skrishnachaitanya09/I-4.0-learning-Laboratory-/Documents/Presentation1.pdf

# Integration of Different Communication Protocols in Industry 4.0 Learning Laboratory

Srivamsi Malladi
Sri Girish Tangirala
Chaitanya Sankaramanchi

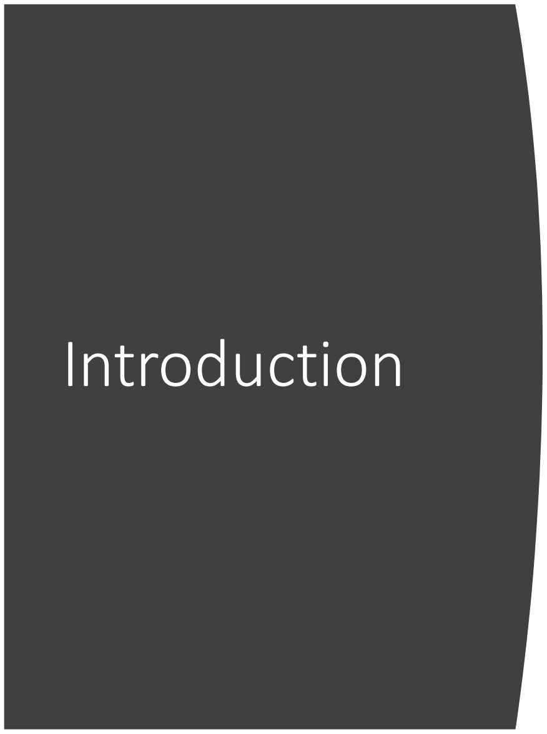
[picture p69: figure]
Introduction

With the increase in the usage of modular components and improvement of intelligence of the devices, the decentralization of the different nodes in a production plant is made possible.

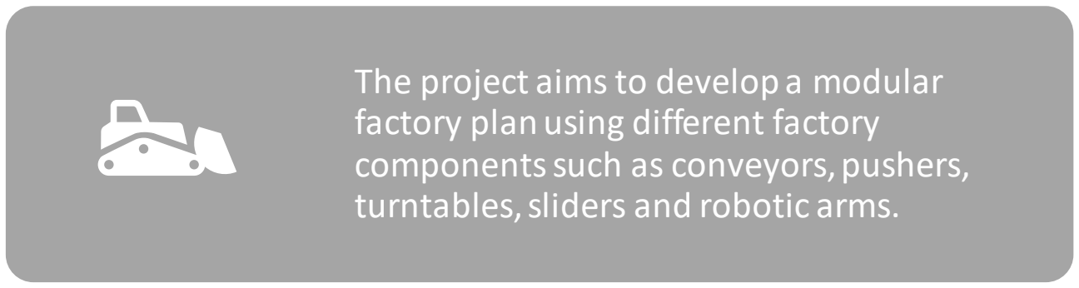
[picture p70: figure]
The project aims to develop a modular factory plan using different factory components such as conveyors, pushers, turntables, sliders and robotic arms.

The project also aims at embedding different communication protocols between the individual nodes in the production plant.

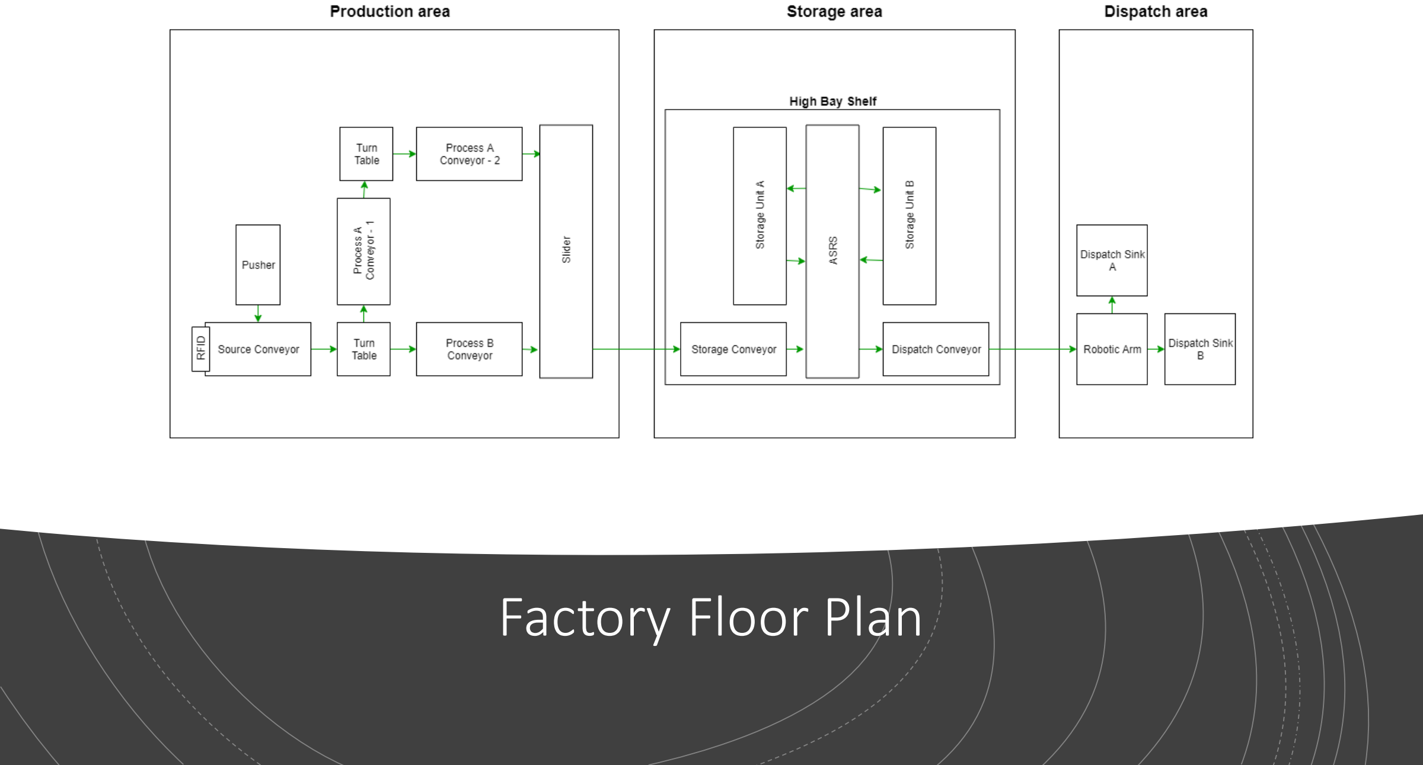
[picture p71: figure]
Factory Floor Plan

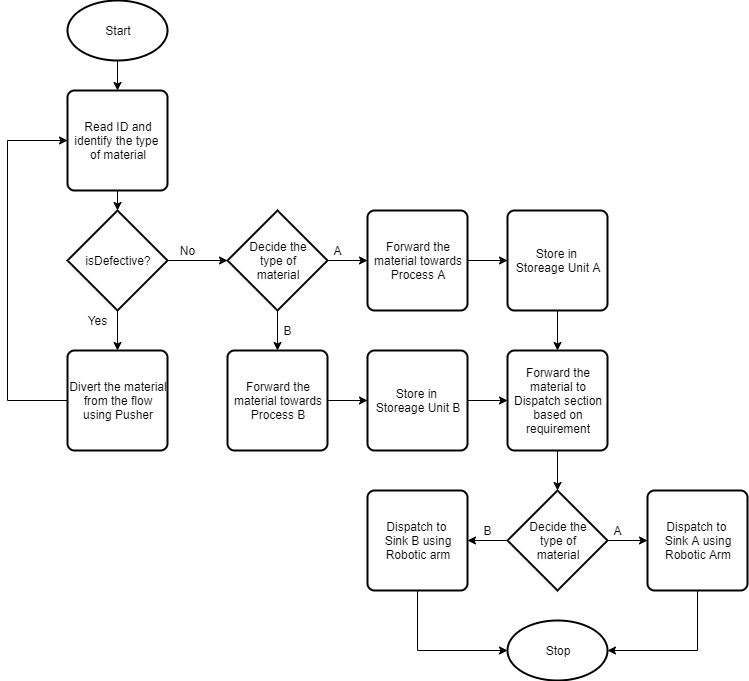
[picture p72: figure]

# Process Flowchart

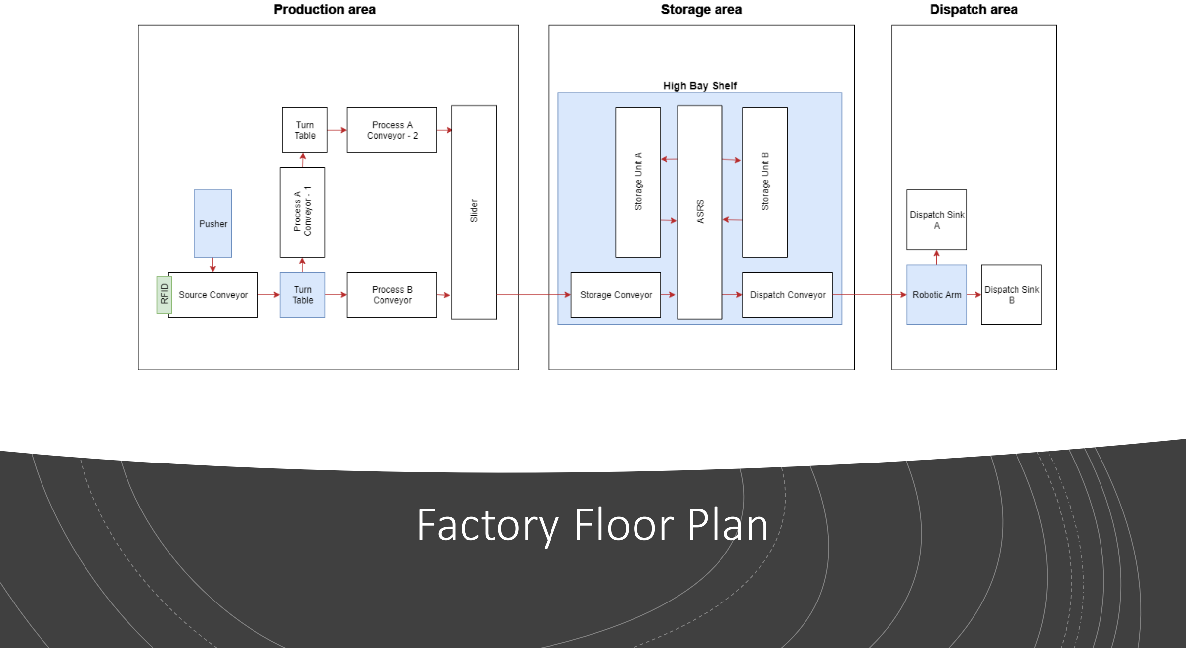
[picture p73: figure]
Factory Floor Plan

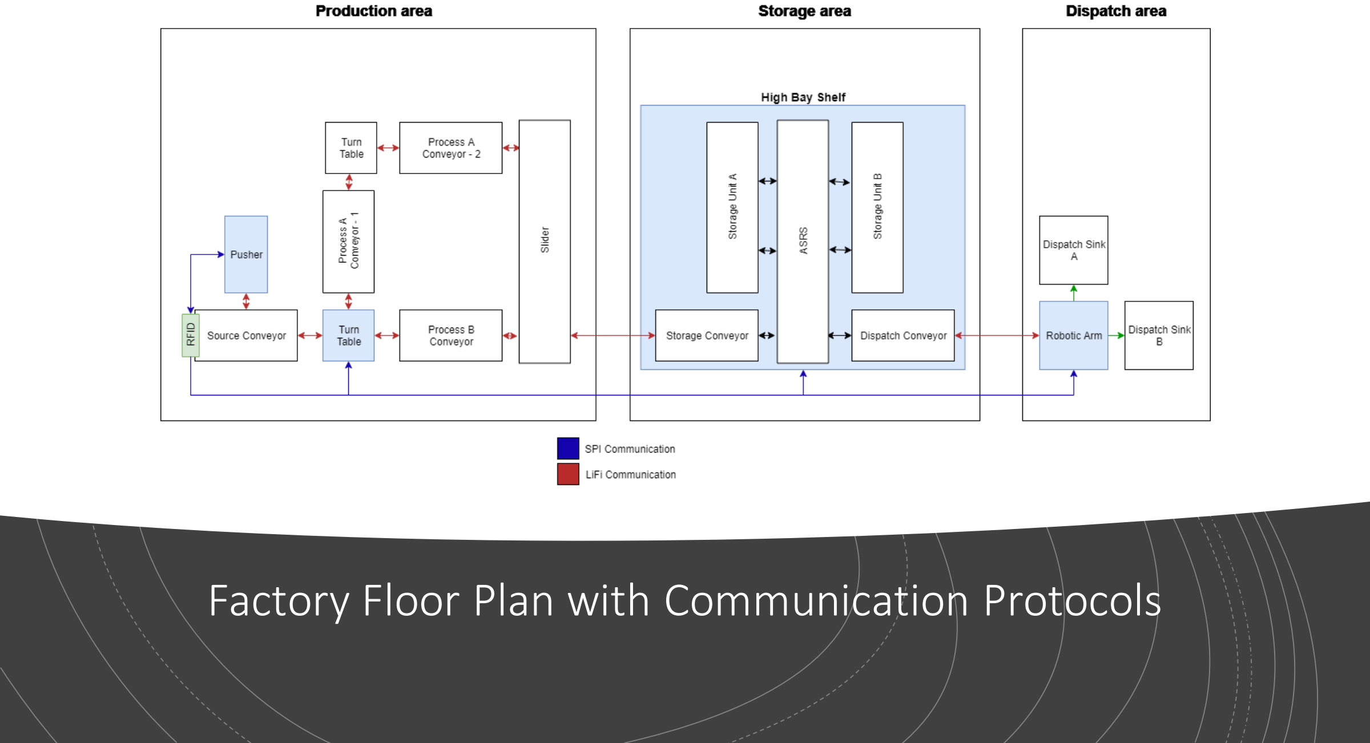
[picture p74: figure]

# Factory Floor Plan with Communication Protocols

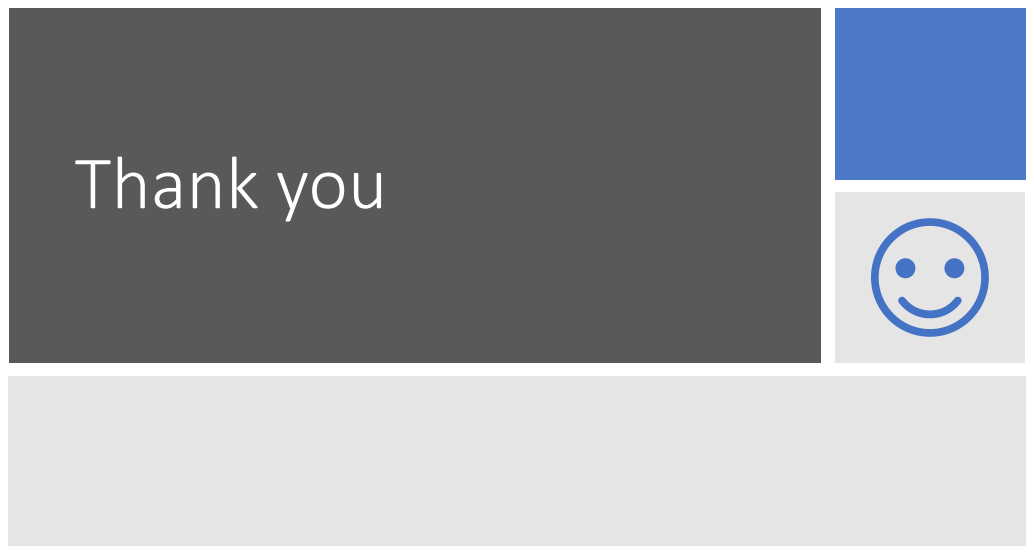
[picture p75: page 7]
Thank you
