skrishnachaitanya09/I-4.0-learning-Laboratory-/Circuit Schematics & Gerber Files/Fritzing/UARt_bb.png

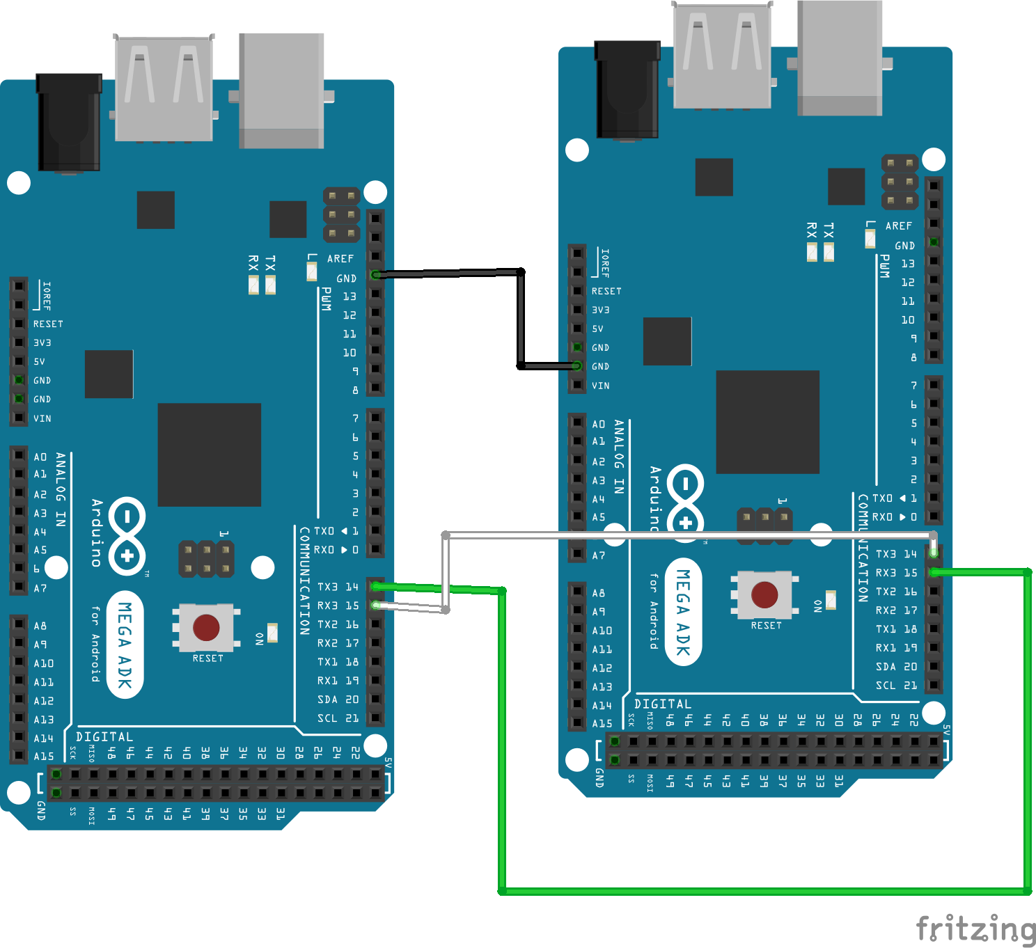
Circuit Schematics & Gerber Files/Fritzing/UARt_bb.png
