skrishnachaitanya09/I-4.0-learning-Laboratory-/Circuit Schematics & Gerber Files/highbay shelf1111/hbs_pcb/hbs_pcb.pdf

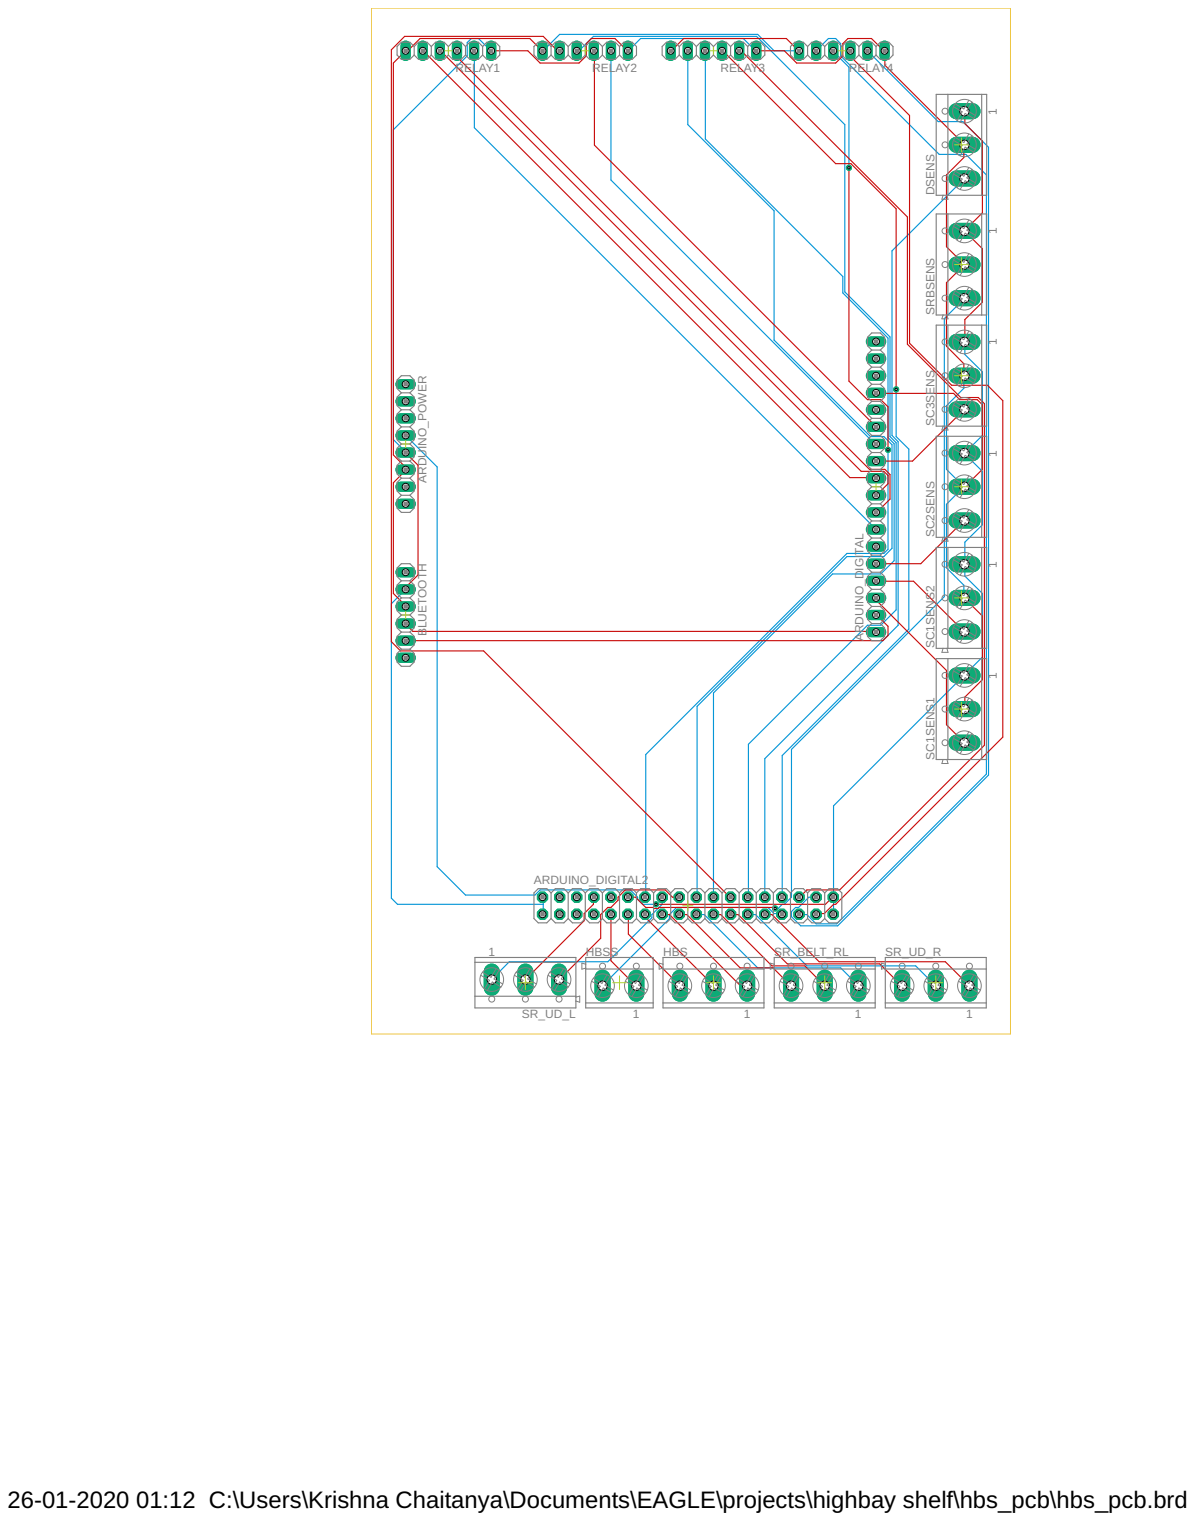
[picture p89: page 1]

26-01-2020 01:12 C:\Users\Krishna Chaitanya\Documents\EAGLE\projects\highbay shelf\hbs_pcb\hbs_pcb.brd
