skrishnachaitanya09/I-4.0-learning-Laboratory-/Circuit Schematics & Gerber Files/highbay shelf1111/hbs_pcb/hbs_pcb_sch.pdf

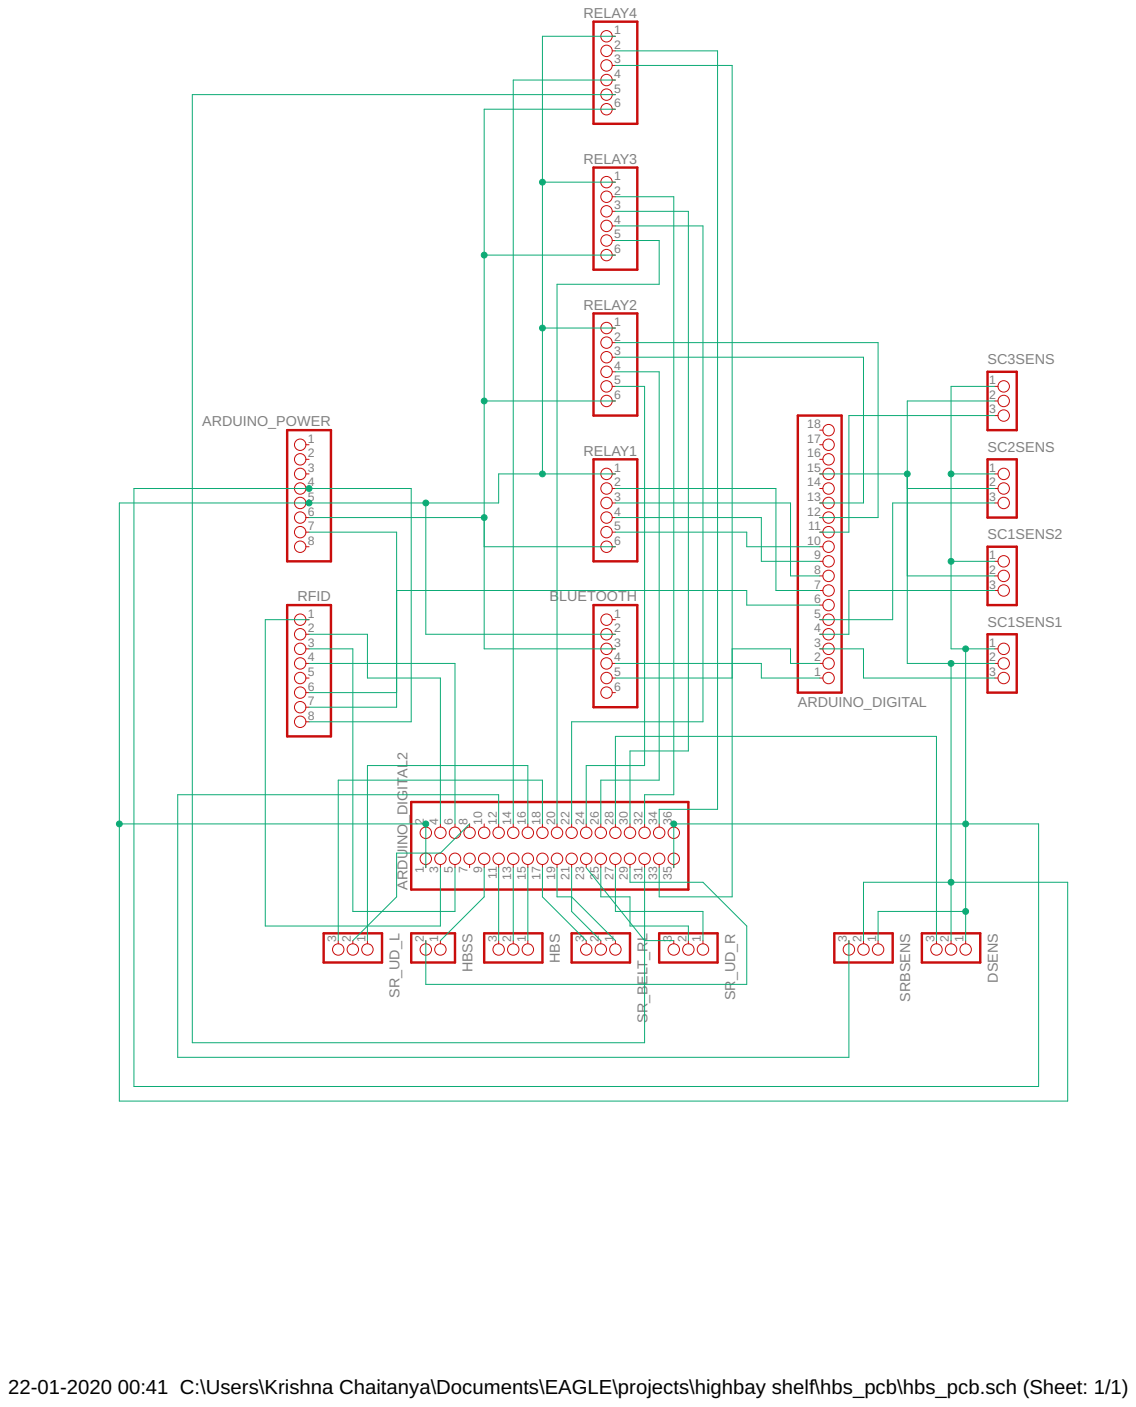
[picture p90: page 1]

22-01-2020 00:41 C:\Users\Krishna Chaitanya\Documents\EAGLE\projects\highbay shelf\hbs_pcb\hbs_pcb.sch (Sheet: 1/1)
