skrishnachaitanya09/I-4.0-learning-Laboratory-/(list of files, drawings)

Other design files:
Circuit Schematics & Gerber Files/Fritzing/bluetooth.fzz
Circuit Schematics & Gerber Files/Fritzing/ir.fzz
Circuit Schematics & Gerber Files/Fritzing/lifi.fzz
Circuit Schematics & Gerber Files/Fritzing/nrf.fzz
Circuit Schematics & Gerber Files/Fritzing/parts/user/relay.fzz
Circuit Schematics & Gerber Files/Fritzing/rfid.fzz
Circuit Schematics & Gerber Files/Fritzing/UARt.fzz
Circuit Schematics & Gerber Files/Fritzing/Untitled Sketch 2.fzz
