skrishnachaitanya09/I-4.0-learning-Laboratory-/Circuit Schematics & Gerber Files/shiield/final_shield/1.brd

## EAGLE design Circuit Schematics & Gerber Files/shiield/final_shield/1.brd (2020-11-26)

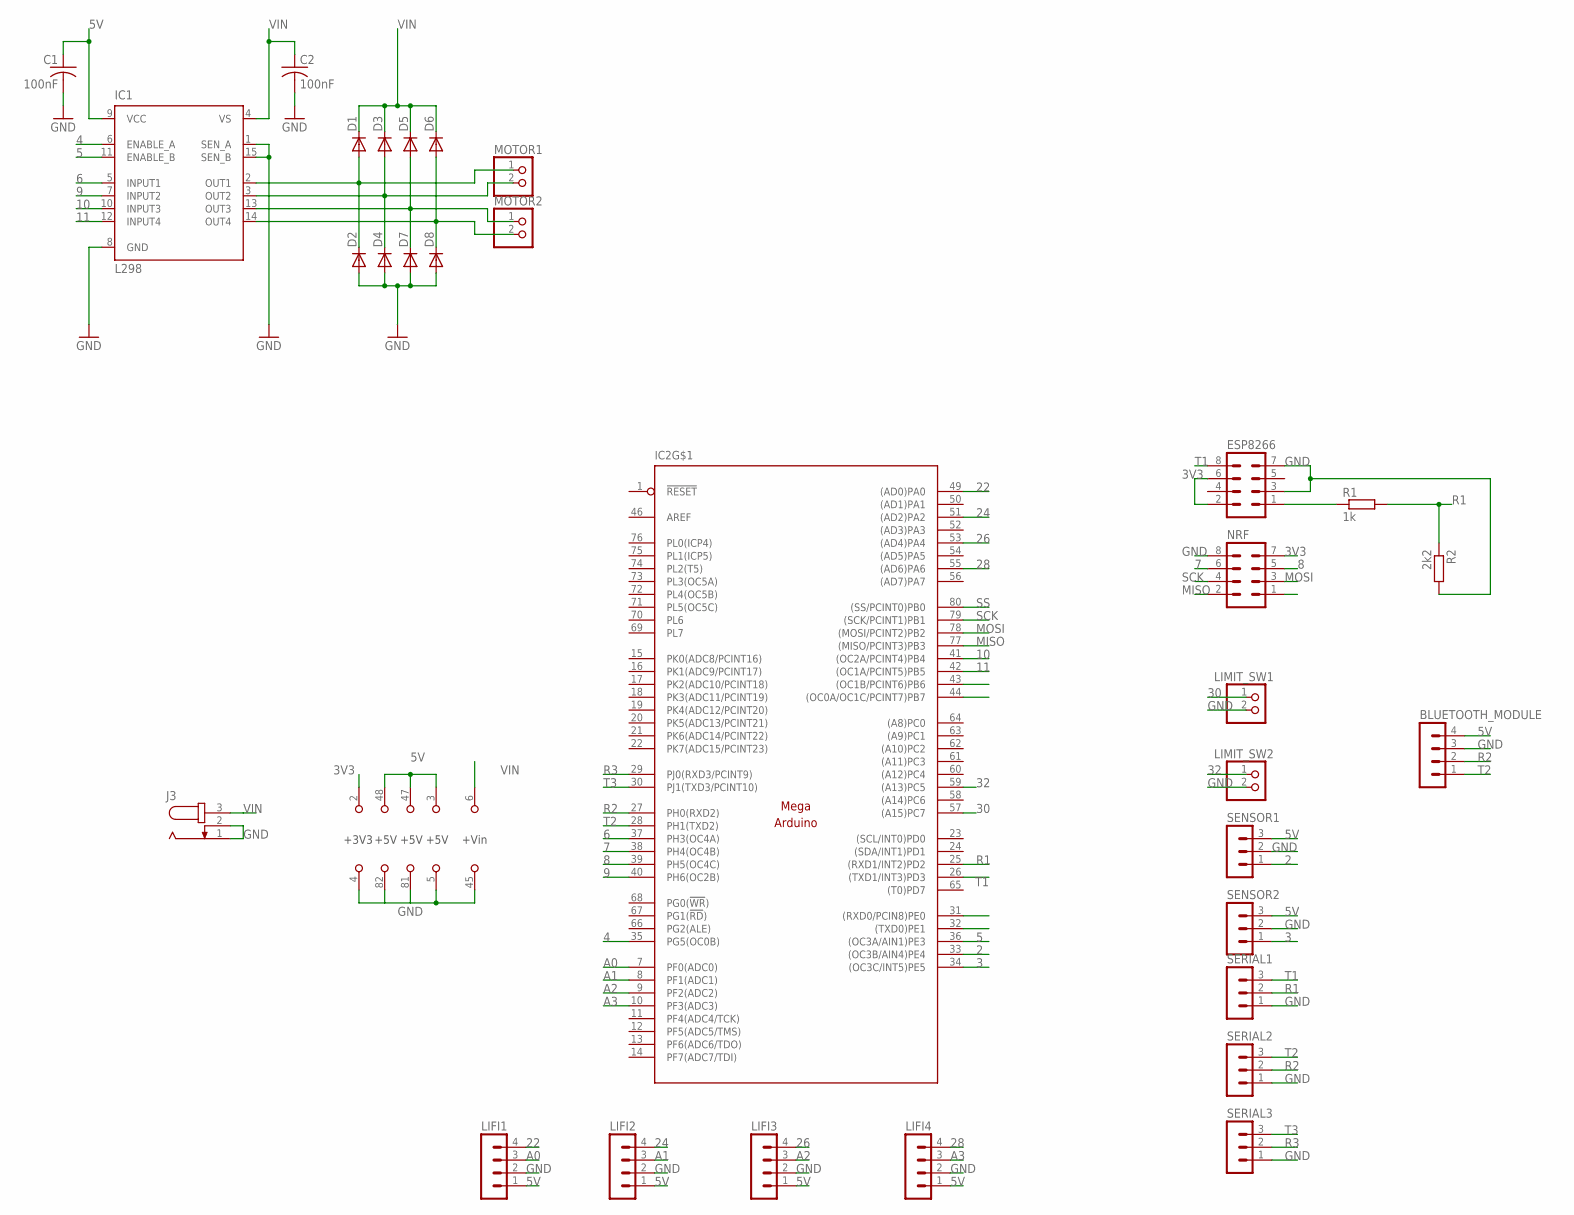
[picture p91: schematic 1.sch]

Parts:
BLUETOOTH_MODULE: MA04-1
C1, C2: 100nF; C050-024X044
D1, D2, D3, D4, D5, D6, D7, D8: DIODE-D-5; D-5
ESP8266: MA04-2
IC1: L298; MULTIWATT-15
IC2: MEGAARDUINO_21; MEGA_ARDUINO_1
J3: JACK-PLUG0; SPC4077
LIFI1, LIFI2, LIFI3, LIFI4: MA04-1
LIMIT_SW1, LIMIT_SW2: PINHD-1X2; 1X02
MOTOR1, MOTOR2: PINHD-1X2; 1X02
NRF: MA04-2
R1: 1k; 0204/7
R2: 2k2; 0204/7
SENSOR1, SENSOR2: MA03-1
SERIAL1, SERIAL2, SERIAL3: MA03-1

Connections:
2: IC2.33 ((OC3B/AIN4)PE4), SENSOR1.1
3: IC2.34 ((OC3C/INT5)PE5), SENSOR2.1
3V3: ESP8266.2, ESP8266.6, IC2.2 (+3V3), NRF.7
4: IC1.6 (ENABLE_A), IC2.35 (PG5(OC0B))
5: IC1.11 (ENABLE_B), IC2.36 ((OC3A/AIN1)PE3)
5V: BLUETOOTH_MODULE.4, C1.1, IC1.9 (VCC), IC2.3 (+5V), IC2.47 (+5V), IC2.48 (+5V), LIFI1.1, LIFI2.1, LIFI3.1, LIFI4.1, SENSOR1.3, SENSOR2.3
6: IC1.5 (INPUT1), IC2.37 (PH3(OC4A))
7: IC2.38 (PH4(OC4B)), NRF.6
8: IC2.39 (PH5(OC4C)), NRF.5
9: IC1.7 (INPUT2), IC2.40 (PH6(OC2B))
10: IC1.10 (INPUT3), IC2.41 ((OC2A/PCINT4)PB4)
11: IC1.12 (INPUT4), IC2.42 ((OC1A/PCINT5)PB5)
22: IC2.49 ((AD0)PA0), LIFI1.4
24: IC2.51 ((AD2)PA2), LIFI2.4
26: IC2.53 ((AD4)PA4), LIFI3.4
28: IC2.55 ((AD6)PA6), LIFI4.4
30: IC2.57 ((A15)PC7), LIMIT_SW1.1
32: IC2.59 ((A13)PC5), LIMIT_SW2.1
A0: IC2.7 (PF0(ADC0)), LIFI1.3
A1: IC2.8 (PF1(ADC1)), LIFI2.3
A2: IC2.9 (PF2(ADC2)), LIFI3.3
A3: IC2.10 (PF3(ADC3)), LIFI4.3
GND: BLUETOOTH_MODULE.3, C1.2, C2.2, D2.A, D4.A, D7.A, D8.A, ESP8266.3, ESP8266.7, IC1.1 (SEN_A), IC1.8 (GND), IC1.15 (SEN_B), IC2.4 (GND), IC2.5 (GND), IC2.45 (GND), IC2.81 (GND), IC2.82 (GND), J3.1, J3.2, LIFI1.2, LIFI2.2, LIFI3.2, LIFI4.2, LIMIT_SW1.2, LIMIT_SW2.2, NRF.8, R2.2, SENSOR1.2, SENSOR2.2, SERIAL1.1, SERIAL2.1, SERIAL3.1
MISO: IC2.77 ((MISO/PCINT3)PB3), NRF.2
MOSI: IC2.78 ((MOSI/PCINT2)PB2), NRF.3
unnamed: D1.A, D2.C, IC1.2 (OUT1), MOTOR1.1
unnamed: D3.A, D4.C, IC1.3 (OUT2), MOTOR1.2
unnamed: D6.A, D8.C, IC1.14 (OUT4), MOTOR2.2
unnamed: D5.A, D7.C, IC1.13 (OUT3), MOTOR2.1
unnamed: ESP8266.1, R1.1
R1: IC2.25 ((RXD1/INT2)PD2), R1.2, R2.1, SERIAL1.2
R2: BLUETOOTH_MODULE.2, IC2.27 (PH0(RXD2)), SERIAL2.2
R3: IC2.29 (PJ0(RXD3/PCINT9)), SERIAL3.2
SCK: IC2.79 ((SCK/PCINT1)PB1), NRF.4
SS: IC2.80 ((SS/PCINT0)PB0)
T1: ESP8266.8, IC2.26 ((TXD1/INT3)PD3), SERIAL1.3
T2: BLUETOOTH_MODULE.1, IC2.28 (PH1(TXD2)), SERIAL2.3
T3: IC2.30 (PJ1(TXD3/PCINT10)), SERIAL3.3
VIN: C2.1, D1.C, D3.C, D5.C, D6.C, IC1.4 (VS), IC2.6 (+VIN), J3.3

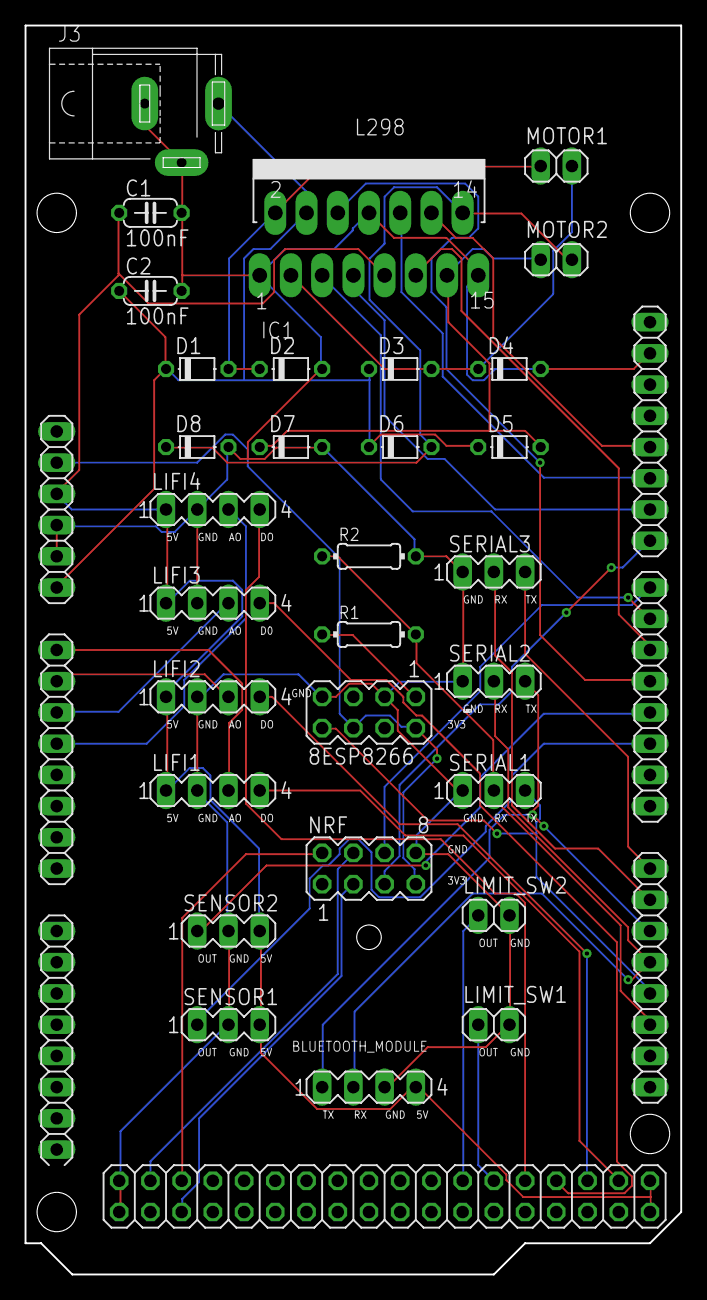
[picture p92: board 1.brd from above]

Board: 2 copper layers, 53.3 x 101.6 mm, 31 parts (0 on the bottom side), 38 nets.
