skrishnachaitanya09/I-4.0-learning-Laboratory-/Circuit Schematics & Gerber Files/hbs/hbs.brd

## EAGLE design Circuit Schematics & Gerber Files/hbs/hbs.brd (2020-11-26)

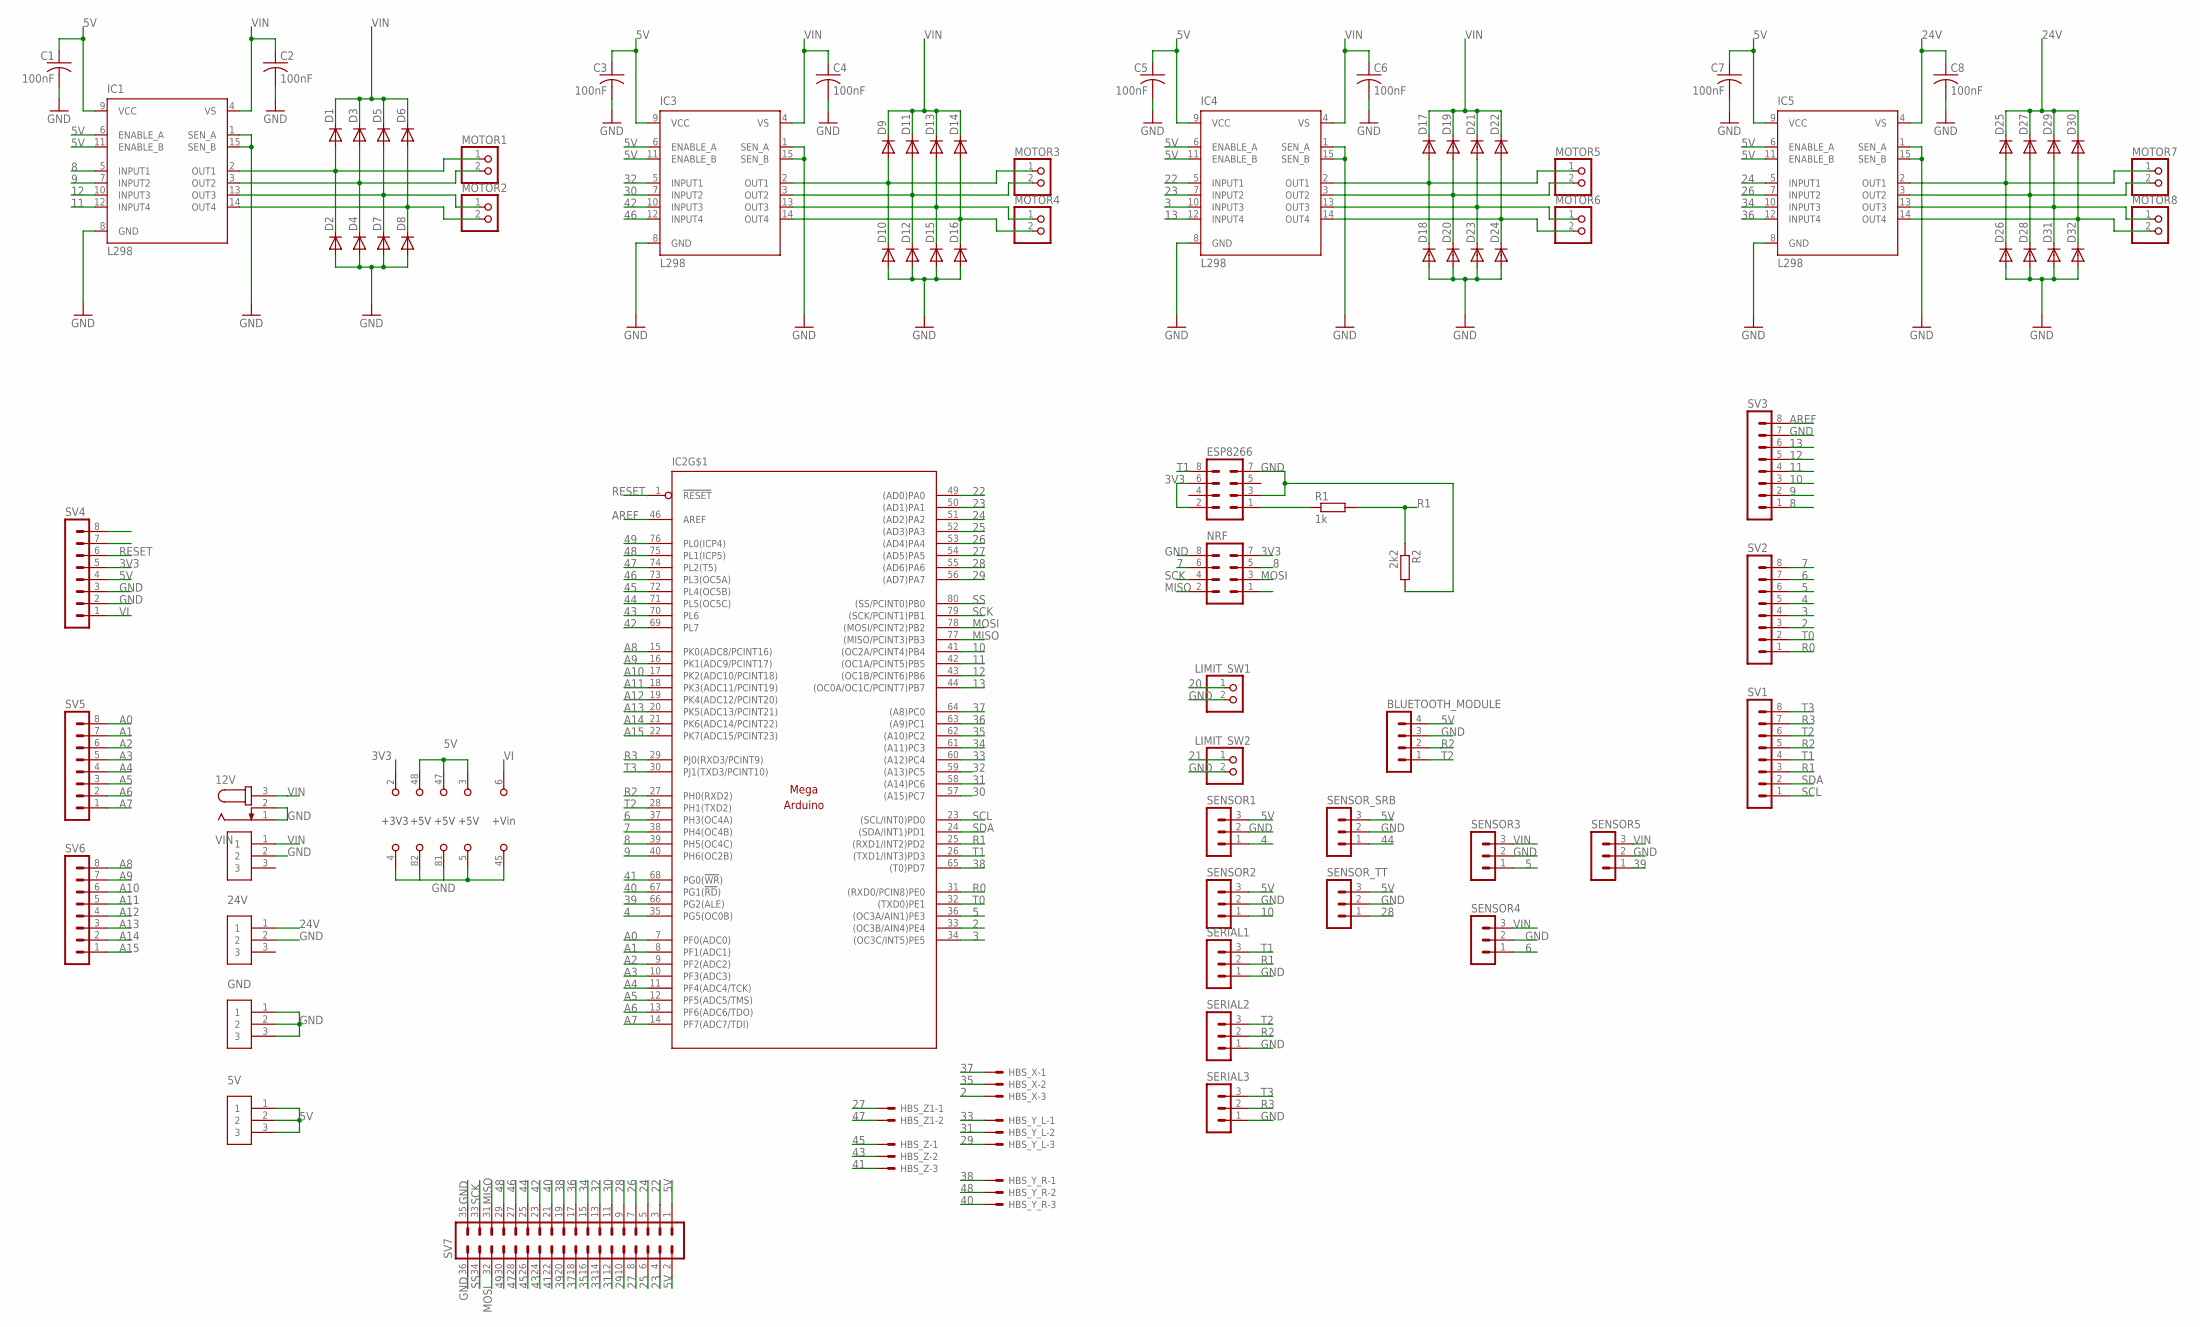
[picture p93: schematic hbs.sch]

Parts:
5V, 24V: 691311500003; TERMINALBLOCK_PLUGGABLE-3-5.08MM
12V: JACK-PLUG0; SPC4077
BLUETOOTH_MODULE: MA04-1
C1, C2, C3, C4, C5, C6, C7, C8: 100nF; C050-024X044
D1, D2, D3, D4, D5, D6, D7, D8, D9, D10, D11, D12, D13, D14, D15, D16, D17, D18, D19, D20, D21, D22, D23, D24, D25, D26, D27, D28, D29, D30, D31, D32: DIODE-D-5; D-5
ESP8266: MA04-2
GND: 691311500003; TERMINALBLOCK_PLUGGABLE-3-5.08MM
HBS_X: JST-XH-03-PIN-LONG-PAD; JST-XH-03-PACKAGE-LONG-PAD
HBS_Y_L: JST-XH-03-PIN-LONG-PAD; JST-XH-03-PACKAGE-LONG-PAD
HBS_Y_R: JST-XH-03-PIN-LONG-PAD; JST-XH-03-PACKAGE-LONG-PAD
HBS_Z: JST-XH-03-PIN-LONG-PAD; JST-XH-03-PACKAGE-LONG-PAD
HBS_Z1: JST-XH-02-PIN-LONG-PAD; JST-XH-02-PACKAGE-LONG-PAD
IC1, IC3, IC4, IC5: L298; MULTIWATT-15
IC2: MEGAARDUINO_21; MEGA_ARDUINO_1
LIMIT_SW1, LIMIT_SW2: PINHD-1X2; 1X02
MOTOR1, MOTOR2, MOTOR3, MOTOR4, MOTOR5, MOTOR6, MOTOR7, MOTOR8: PINHD-1X2; 1X02
NRF: MA04-2
R1: 1k; 0204/7
R2: 2k2; 0204/7
SENSOR1, SENSOR2, SENSOR3, SENSOR4, SENSOR5: MA03-1
SENSOR_SRB: MA03-1
SENSOR_TT: MA03-1
SERIAL1, SERIAL2, SERIAL3: MA03-1
SV1, SV2, SV3, SV4, SV5, SV6: MA08-1
SV7: MA18-2
VIN: 691311500003; TERMINALBLOCK_PLUGGABLE-3-5.08MM

Connections:
2: HBS_X.3, IC2.33 ((OC3B/AIN4)PE4), SV2.3
3: IC2.34 ((OC3C/INT5)PE5), IC4.10 (INPUT3), SV2.4
3V3: ESP8266.2, ESP8266.6, IC2.2 (+3V3), NRF.7, SV4.5
4: IC2.35 (PG5(OC0B)), SENSOR1.1, SV2.5
5: IC2.36 ((OC3A/AIN1)PE3), SENSOR3.1, SV2.6
5V: 5V.1, 5V.2, 5V.3, BLUETOOTH_MODULE.4, C1.1, C3.1, C5.1, C7.1, IC1.6 (ENABLE_A), IC1.9 (VCC), IC1.11 (ENABLE_B), IC2.3 (+5V), IC2.47 (+5V), IC2.48 (+5V), IC3.6 (ENABLE_A), IC3.9 (VCC), IC3.11 (ENABLE_B), IC4.6 (ENABLE_A), IC4.9 (VCC), IC4.11 (ENABLE_B), IC5.6 (ENABLE_A), IC5.9 (VCC), IC5.11 (ENABLE_B), SENSOR1.3, SENSOR2.3, SENSOR_SRB.3, SENSOR_TT.3, SV4.4, SV7.1, SV7.2
6: IC2.37 (PH3(OC4A)), SENSOR4.1, SV2.7
7: IC2.38 (PH4(OC4B)), NRF.6, SV2.8
8: IC1.5 (INPUT1), IC2.39 (PH5(OC4C)), NRF.5, SV3.1
9: IC1.7 (INPUT2), IC2.40 (PH6(OC2B)), SV3.2
10: IC2.41 ((OC2A/PCINT4)PB4), SENSOR2.1, SV3.3
11: IC1.12 (INPUT4), IC2.42 ((OC1A/PCINT5)PB5), SV3.4
12: IC1.10 (INPUT3), IC2.43 ((OC1B/PCINT6)PB6), SV3.5
13: IC2.44 ((OC0A/OC1C/PCINT7)PB7), IC4.12 (INPUT4), SV3.6
20: LIMIT_SW1.1
21: LIMIT_SW2.1
22: IC2.49 ((AD0)PA0), IC4.5 (INPUT1), SV7.3
23: IC2.50 ((AD1)PA1), IC4.7 (INPUT2), SV7.4
24: IC2.51 ((AD2)PA2), IC5.5 (INPUT1), SV7.5
24V: 24V.1, C8.1, D25.C, D27.C, D29.C, D30.C, IC5.4 (VS)
25: IC2.52 ((AD3)PA3), SV7.6
26: IC2.53 ((AD4)PA4), IC5.7 (INPUT2), SV7.7
27: HBS_Z1.1, IC2.54 ((AD5)PA5), SV7.8
28: IC2.55 ((AD6)PA6), SENSOR_TT.1, SV7.9
29: HBS_Y_L.3, IC2.56 ((AD7)PA7), SV7.10
30: IC2.57 ((A15)PC7), IC3.7 (INPUT2), SV7.11
31: HBS_Y_L.2, IC2.58 ((A14)PC6), SV7.12
32: IC2.59 ((A13)PC5), IC3.5 (INPUT1), SV7.13
33: HBS_Y_L.1, IC2.60 ((A12)PC4), SV7.14
34: IC2.61 ((A11)PC3), IC5.10 (INPUT3), SV7.15
35: HBS_X.2, IC2.62 ((A10)PC2), SV7.16
36: IC2.63 ((A9)PC1), IC5.12 (INPUT4), SV7.17
37: HBS_X.1, IC2.64 ((A8)PC0), SV7.18
38: HBS_Y_R.1, IC2.65 ((T0)PD7), SV7.19
39: IC2.66 (PG2(ALE)), SENSOR5.1, SV7.20
40: HBS_Y_R.3, IC2.67 (PG1(!RD!)), SV7.21
41: HBS_Z.3, IC2.68 (PG0(!WR!)), SV7.22
42: IC2.69 (PL7), IC3.10 (INPUT3), SV7.23
43: HBS_Z.2, IC2.70 (PL6), SV7.24
44: IC2.71 (PL5(OC5C)), SENSOR_SRB.1, SV7.25
45: HBS_Z.1, IC2.72 (PL4(OC5B)), SV7.26
46: IC2.73 (PL3(OC5A)), IC3.12 (INPUT4), SV7.27
47: HBS_Z1.2, IC2.74 (PL2(T5)), SV7.28
48: HBS_Y_R.2, IC2.75 (PL1(ICP5)), SV7.29
49: IC2.76 (PL0(ICP4)), SV7.30
A0: IC2.7 (PF0(ADC0)), SV5.8
A1: IC2.8 (PF1(ADC1)), SV5.7
A2: IC2.9 (PF2(ADC2)), SV5.6
A3: IC2.10 (PF3(ADC3)), SV5.5
A4: IC2.11 (PF4(ADC4/TCK)), SV5.4
A5: IC2.12 (PF5(ADC5/TMS)), SV5.3
A6: IC2.13 (PF6(ADC6/TDO)), SV5.2
A7: IC2.14 (PF7(ADC7/TDI)), SV5.1
A8: IC2.15 (PK0(ADC8/PCINT16)), SV6.8
A9: IC2.16 (PK1(ADC9/PCINT17)), SV6.7
A10: IC2.17 (PK2(ADC10/PCINT18)), SV6.6
A11: IC2.18 (PK3(ADC11/PCINT19)), SV6.5
A12: IC2.19 (PK4(ADC12/PCINT20)), SV6.4
A13: IC2.20 (PK5(ADC13/PCINT21)), SV6.3
A14: IC2.21 (PK6(ADC14/PCINT22)), SV6.2
A15: IC2.22 (PK7(ADC15/PCINT23)), SV6.1
AREF: IC2.46 (AREF), SV3.8
GND: 12V.1, 12V.2, 24V.2, BLUETOOTH_MODULE.3, C1.2, C2.2, C3.2, C4.2, C5.2, C6.2, C7.2, C8.2, D2.A, D4.A, D7.A, D8.A, D10.A, D12.A, D15.A, D16.A, D18.A, D20.A, D23.A, D24.A, D26.A, D28.A, D31.A, D32.A, ESP8266.3, ESP8266.7, GND.1, GND.2, GND.3, IC1.1 (SEN_A), IC1.8 (GND), IC1.15 (SEN_B), IC2.4 (GND), IC2.5 (GND), IC2.45 (GND), IC2.81 (GND), IC2.82 (GND), IC3.1 (SEN_A), IC3.8 (GND), IC3.15 (SEN_B), IC4.1 (SEN_A), IC4.8 (GND), IC4.15 (SEN_B), IC5.1 (SEN_A), IC5.8 (GND), IC5.15 (SEN_B), LIMIT_SW1.2, LIMIT_SW2.2, NRF.8, R2.2, SENSOR1.2, SENSOR2.2, SENSOR3.2, SENSOR4.2, SENSOR5.2, SENSOR_SRB.2, SENSOR_TT.2, SERIAL1.1, SERIAL2.1, SERIAL3.1, SV3.7, SV4.2, SV4.3, SV7.35, SV7.36, VIN.2
MISO: IC2.77 ((MISO/PCINT3)PB3), NRF.2, SV7.31
MOSI: IC2.78 ((MOSI/PCINT2)PB2), NRF.3, SV7.32
unnamed: D1.A, D2.C, IC1.2 (OUT1), MOTOR1.1
unnamed: D3.A, D4.C, IC1.3 (OUT2), MOTOR1.2
unnamed: D6.A, D8.C, IC1.14 (OUT4), MOTOR2.2
unnamed: D5.A, D7.C, IC1.13 (OUT3), MOTOR2.1
unnamed: ESP8266.1, R1.1
unnamed: D9.A, D10.C, IC3.2 (OUT1), MOTOR3.1
unnamed: D11.A, D12.C, IC3.3 (OUT2), MOTOR3.2
unnamed: D14.A, D16.C, IC3.14 (OUT4), MOTOR4.2
unnamed: D13.A, D15.C, IC3.13 (OUT3), MOTOR4.1
unnamed: D17.A, D18.C, IC4.2 (OUT1), MOTOR5.1
unnamed: D19.A, D20.C, IC4.3 (OUT2), MOTOR5.2
unnamed: D22.A, D24.C, IC4.14 (OUT4), MOTOR6.2
unnamed: D21.A, D23.C, IC4.13 (OUT3), MOTOR6.1
unnamed: D25.A, D26.C, IC5.2 (OUT1), MOTOR7.1
unnamed: D27.A, D28.C, IC5.3 (OUT2), MOTOR7.2
unnamed: D30.A, D32.C, IC5.14 (OUT4), MOTOR8.2
unnamed: D29.A, D31.C, IC5.13 (OUT3), MOTOR8.1
R0: IC2.31 ((RXD0/PCIN8)PE0), SV2.1
R1: IC2.25 ((RXD1/INT2)PD2), R1.2, R2.1, SERIAL1.2, SV1.3
R2: BLUETOOTH_MODULE.2, IC2.27 (PH0(RXD2)), SERIAL2.2, SV1.5
R3: IC2.29 (PJ0(RXD3/PCINT9)), SERIAL3.2, SV1.7
RESET: IC2.1 (!RESET), SV4.6
SCK: IC2.79 ((SCK/PCINT1)PB1), NRF.4, SV7.33
SCL: IC2.23 ((SCL/INT0)PD0), SV1.1
SDA: IC2.24 ((SDA/INT1)PD1), SV1.2
SS: IC2.80 ((SS/PCINT0)PB0), SV7.34
T0: IC2.32 ((TXD0)PE1), SV2.2
T1: ESP8266.8, IC2.26 ((TXD1/INT3)PD3), SERIAL1.3, SV1.4
T2: BLUETOOTH_MODULE.1, IC2.28 (PH1(TXD2)), SERIAL2.3, SV1.6
T3: IC2.30 (PJ1(TXD3/PCINT10)), SERIAL3.3, SV1.8
VI: IC2.6 (+VIN), SV4.1
VIN: 12V.3, C2.1, C4.1, C6.1, D1.C, D3.C, D5.C, D6.C, D9.C, D11.C, D13.C, D14.C, D17.C, D19.C, D21.C, D22.C, IC1.4 (VS), IC3.4 (VS), IC4.4 (VS), SENSOR3.3, SENSOR4.3, SENSOR5.3, VIN.1

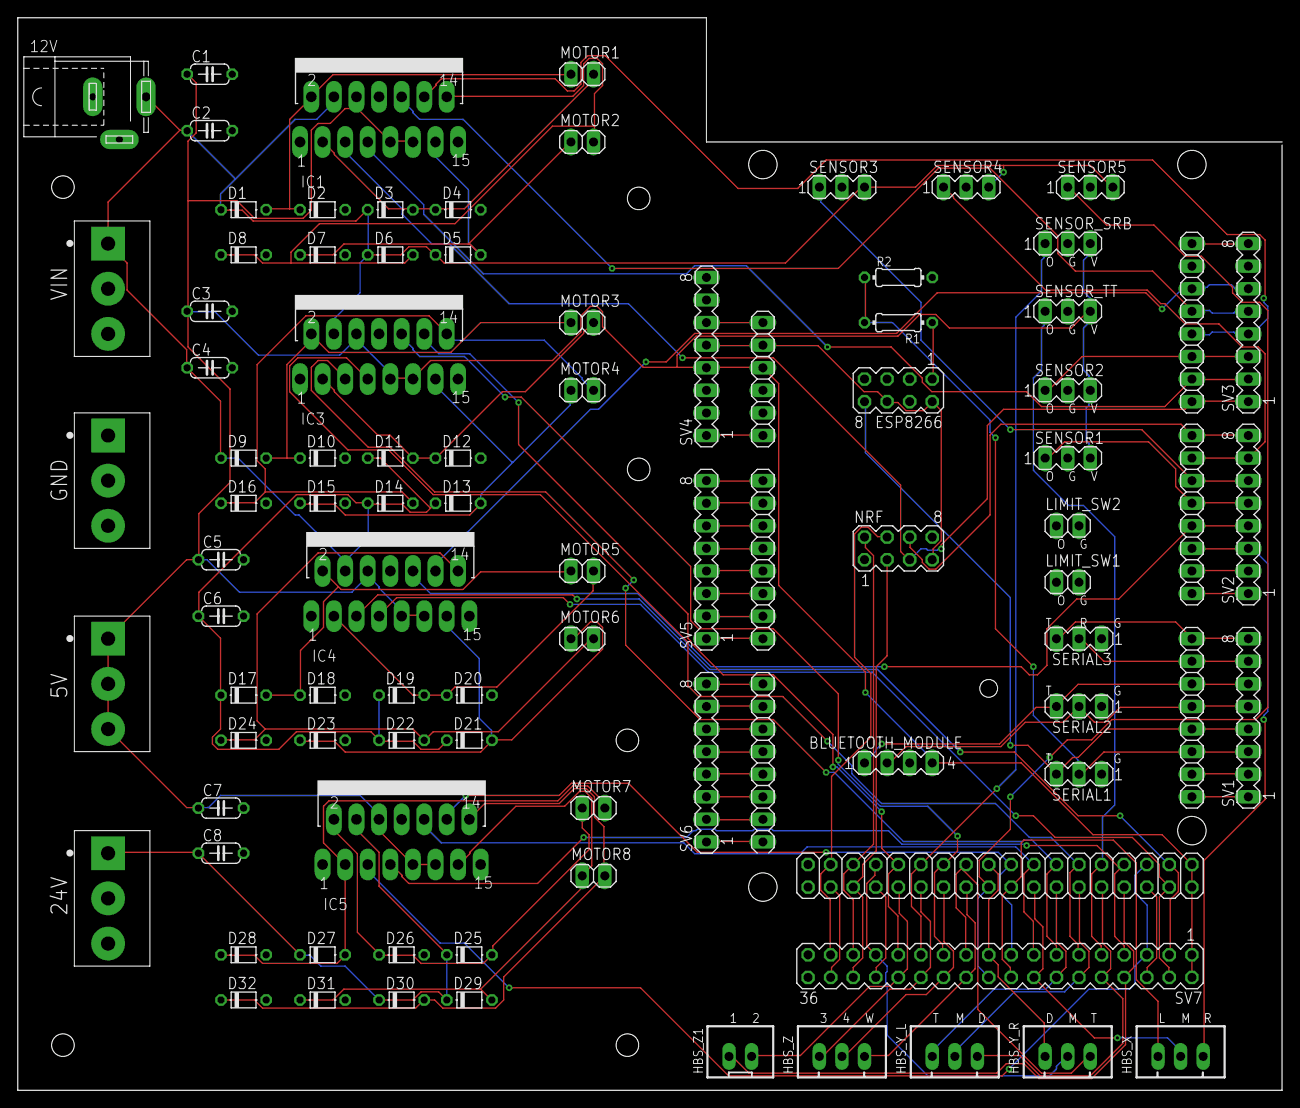
[picture p94: board hbs.brd from above]

Board: 2 copper layers, 142.2 x 120.7 mm, 87 parts (0 on the bottom side), 95 nets.
