skrishnachaitanya09/I-4.0-learning-Laboratory-/Circuit Schematics & Gerber Files/highbay shelf1111/hbs/sch.brd

## EAGLE design Circuit Schematics & Gerber Files/highbay shelf1111/hbs/sch.brd (2020-03-05)

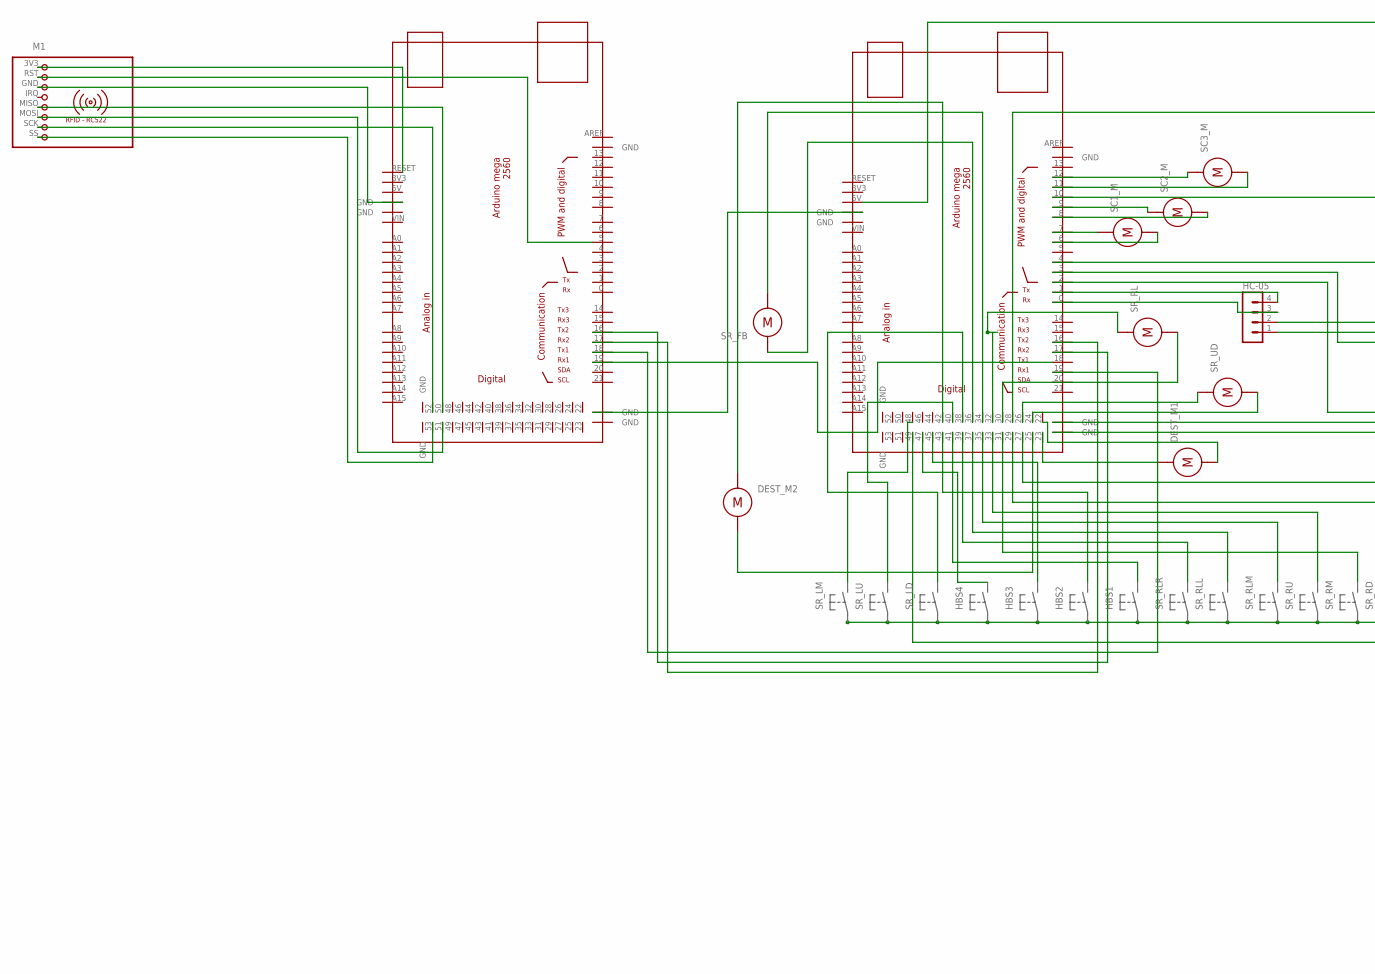
[picture p95: schematic sch.sch, part in row 1, column 1]

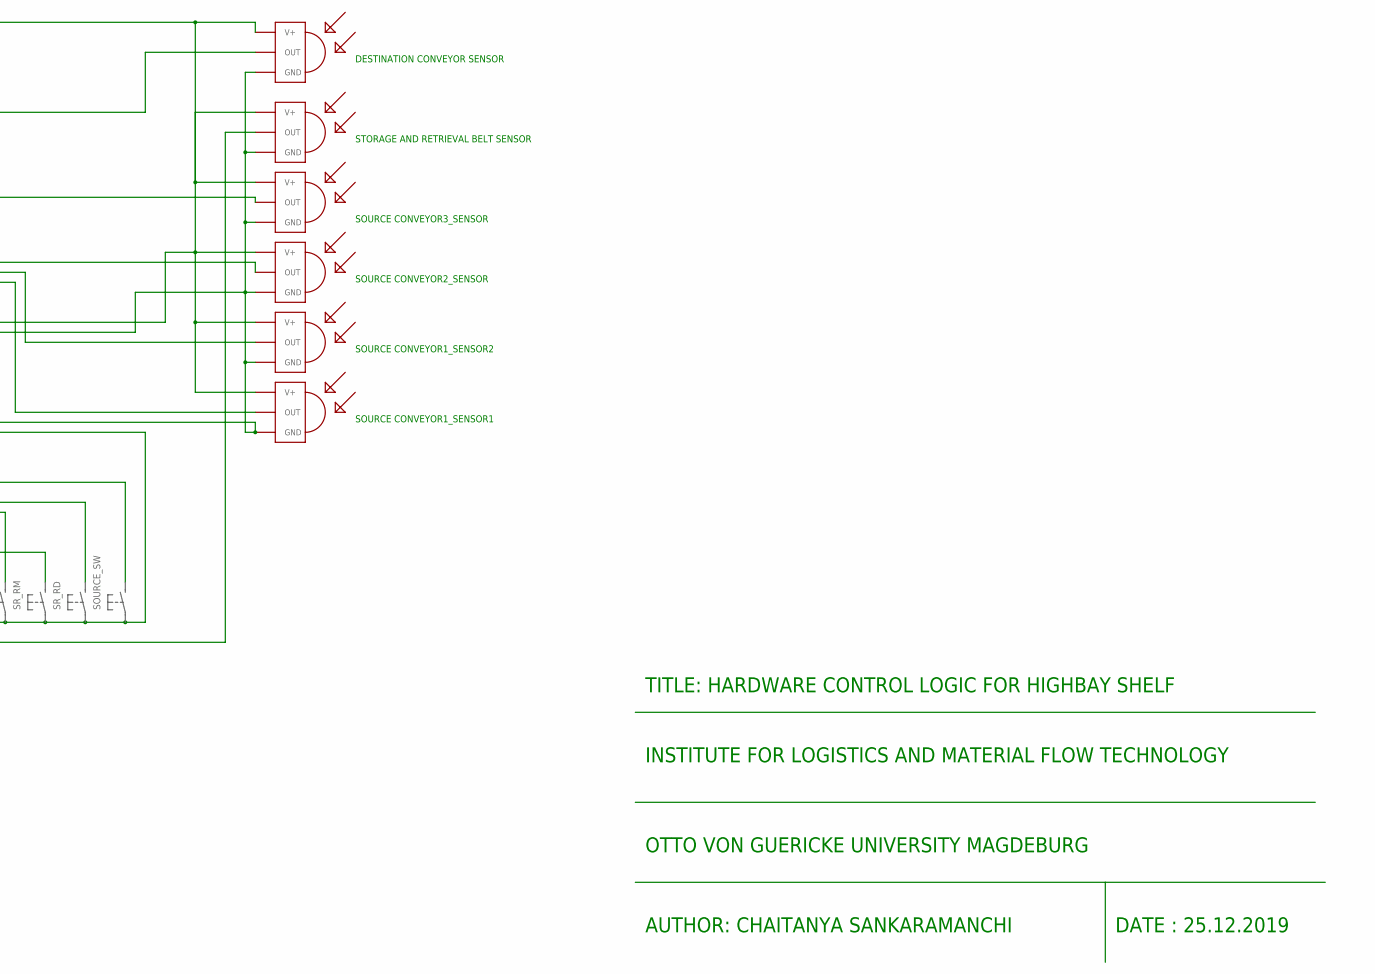
[picture p96: schematic sch.sch, part in row 1, column 2]

Parts:
DEST_M1, DEST_M2: 308-100
HC-05: MA04-1
M1: RFID-RC522
SC1_M, SC2_M, SC3_M: 308-100
SC1_SENS1, SC1_SENS2, SC2_SENS, SC3_SENS: TSOP1730; TSOP17XX
SRB_SENS, SRB_SENS1: TSOP1730; TSOP17XX
SR_FB: 308-100
SR_RL: 308-100
SR_UD: 308-100
U$1, U$2: MEGA_DEVICE; MEGAOUTLINE

Connections:
unnamed: SC1_SENS1.OUT, U$1.2
unnamed: SC1_SENS2.OUT, U$1.3
unnamed: SC2_SENS.OUT, U$1.4
unnamed: SC3_SENS.OUT, U$1.10
unnamed: SRB_SENS.OUT, U$1.49
unnamed: HC-05.2, SC1_SENS1.V+, SC1_SENS2.V+, SC2_SENS.V+, SC3_SENS.V+, SRB_SENS.V+, SRB_SENS1.V+, U$1.5V
unnamed: HC-05.1, SC1_SENS1.GND, SC1_SENS2.GND, SC2_SENS.GND, SC3_SENS.GND, SRB_SENS.GND, SRB_SENS1.GND, U$1.GND@4 (GND)
unnamed: SC1_M.POS, U$1.7
unnamed: SC1_M.NEG, U$1.6
unnamed: SC2_M.POS, U$1.9
unnamed: SC2_M.NEG, U$1.8
unnamed: SC3_M.POS, U$1.12
unnamed: SC3_M.NEG, U$1.11
unnamed: SR_UD.POS, U$1.26
unnamed: SR_UD.NEG, U$1.24
unnamed: SR_RL.NEG, U$1.20, U$1.30
unnamed: SR_FB.NEG, U$1.34
unnamed: SR_FB.POS, U$1.36
unnamed: DEST_M1.NEG, U$1.22
unnamed: DEST_M1.POS, U$1.23
unnamed: DEST_M2.NEG, U$1.25
unnamed: DEST_M2.POS, U$1.42
unnamed: U$1.18, U$2.19
unnamed: U$1.19, U$2.18
unnamed: U$1.17, U$2.16
unnamed: U$1.16, U$2.17
unnamed: U$1.GND@2 (GND), U$2.GND@4 (GND)
unnamed: M1.3V3 (1), U$2.RESET
unnamed: HC-05.4, U$1.1
unnamed: HC-05.3, U$1.0
unnamed: SRB_SENS1.OUT, U$1.28
unnamed: M1.RST (2), U$2.5
unnamed: M1.GND (3), U$2.GND@2 (GND)
unnamed: M1.MISO (5), U$2.50
unnamed: M1.MOSI (6), U$2.51
unnamed: M1.SCK (7), U$2.52
unnamed: M1.SS (8), U$2.53

Notes on the sheet:
SOURCE CONVEYOR1_SENSOR1
SOURCE CONVEYOR1_SENSOR2
SOURCE CONVEYOR2_SENSOR
SOURCE CONVEYOR3_SENSOR
STORAGE AND RETRIEVAL BELT SENSOR
DESTINATION CONVEYOR SENSOR
TITLE: HARDWARE CONTROL LOGIC FOR HIGHBAY SHELF
INSTITUTE FOR LOGISTICS AND MATERIAL FLOW TECHNOLOGY
OTTO VON GUERICKE UNIVERSITY MAGDEBURG
DATE : 25.12.2019
AUTHOR: CHAITANYA SANKARAMANCHI

Board: 2 copper layers, 18 parts (0 on the bottom side), 37 nets, no tracks yet.
