skrishnachaitanya09/I-4.0-learning-Laboratory-/Circuit Schematics & Gerber Files/highbay shelf1111/led/New_Project/untitled.brd

## EAGLE design Circuit Schematics & Gerber Files/highbay shelf1111/led/New_Project/untitled.brd (2020-03-05)

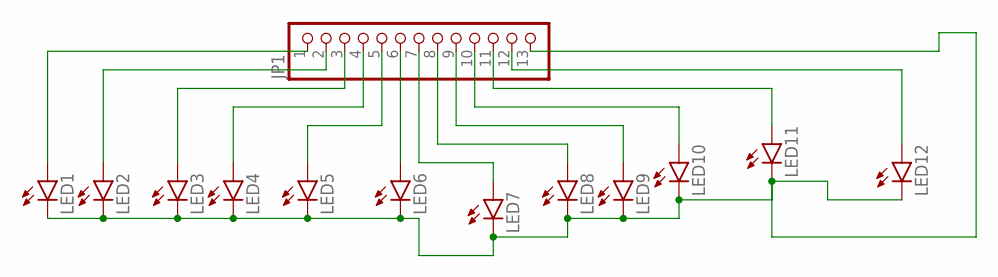
[picture p97: schematic untitled.sch]

Parts:
JP1: PINHD-1X13; 1X13
LED1, LED2, LED3, LED4, LED5, LED6, LED7, LED8, LED9, LED10, LED11, LED12: LED5MM

Connections:
unnamed: JP1.1, LED1.A
unnamed: JP1.2, LED2.A
unnamed: JP1.3, LED3.A
unnamed: JP1.4, LED4.A
unnamed: JP1.5, LED5.A
unnamed: JP1.6, LED6.A
unnamed: JP1.7, LED7.A
unnamed: JP1.8, LED8.A
unnamed: JP1.9, LED9.A
unnamed: JP1.10, LED10.A
unnamed: JP1.11, LED11.A
unnamed: JP1.12, LED12.A
unnamed: JP1.13, LED1.K (C), LED2.K (C), LED3.K (C), LED4.K (C), LED5.K (C), LED6.K (C), LED7.K (C), LED8.K (C), LED9.K (C), LED10.K (C), LED11.K (C), LED12.K (C)

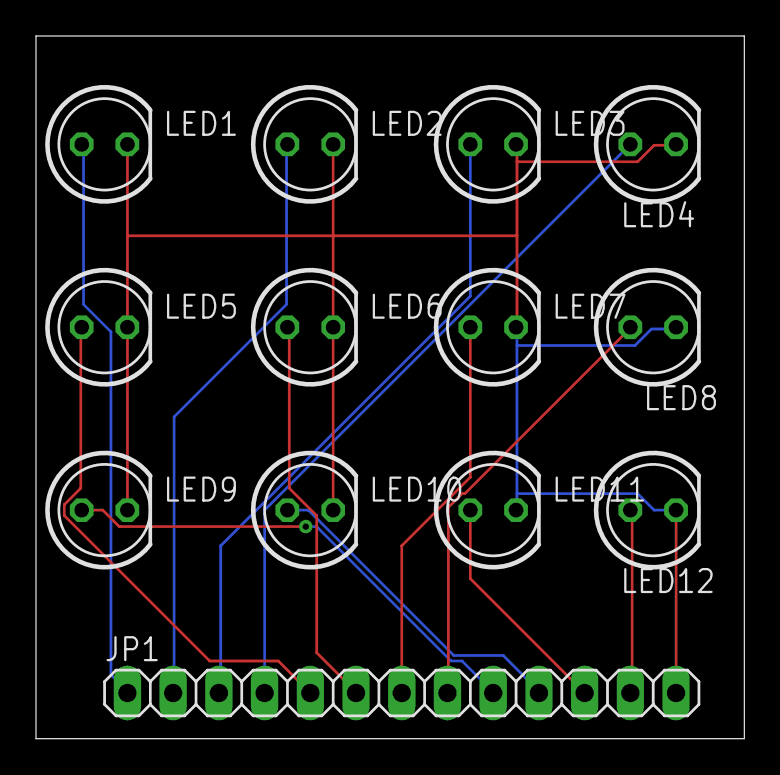
[picture p98: board untitled.brd from above]

Board: 2 copper layers, 39.4 x 39.0 mm, 13 parts (0 on the bottom side), 13 nets.
