skrishnachaitanya09/I-4.0-learning-Laboratory-/Circuit Schematics & Gerber Files/highbay shelf1111/hbs_pcb/hbs_pcb.brd

## EAGLE design Circuit Schematics & Gerber Files/highbay shelf1111/hbs_pcb/hbs_pcb.brd (2020-03-05)

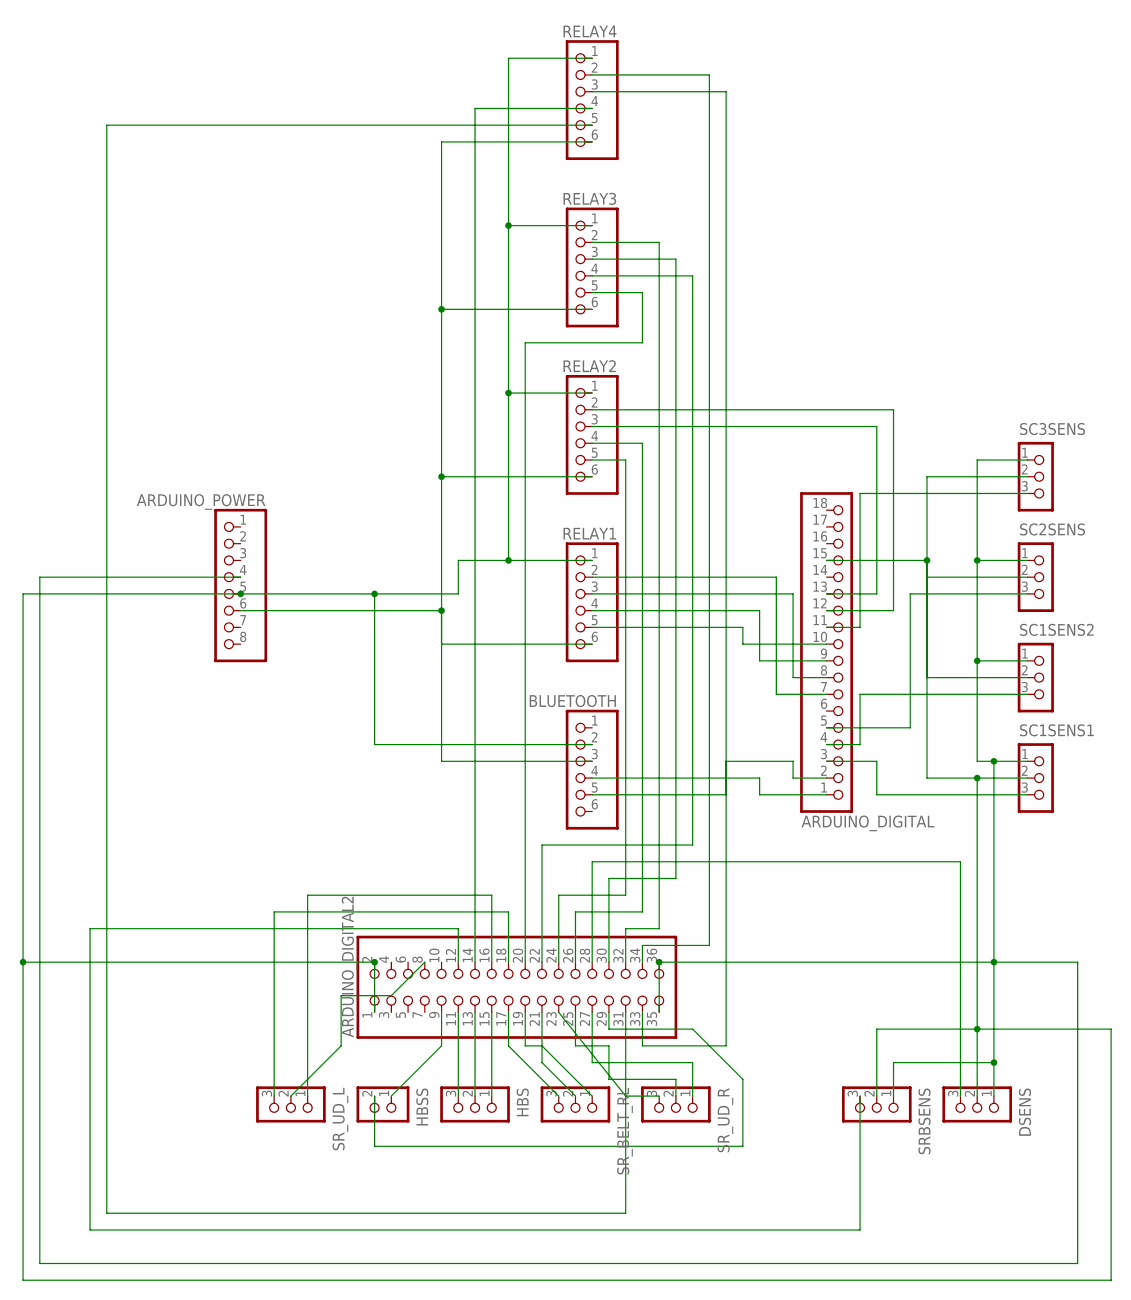
[picture p99: schematic hbs_pcb.sch]

Parts:
ARDUINO_DIGITAL: PINHD-1X18; 1X18
ARDUINO_DIGITAL2: PINHD-2X18; 2X18
ARDUINO_POWER: PINHD-1X8; 1X08
BLUETOOTH: PINHD-1X6; 1X06
DSENS: CON_TERMINAL_BLOCK_03-5MM; TERMINAL_BLOCK_3P_5
HBS: CON_TERMINAL_BLOCK_03-5MM; TERMINAL_BLOCK_3P_5
HBSS: CON_TERMINAL_BLOCK_02-5MM; TERMINAL_BLOCK_2P_5
RELAY1, RELAY2, RELAY3, RELAY4: PINHD-1X6; 1X06
SC1SENS1, SC1SENS2, SC2SENS, SC3SENS: CON_TERMINAL_BLOCK_03-5MM; TERMINAL_BLOCK_3P_5
SRBSENS: CON_TERMINAL_BLOCK_03-5MM; TERMINAL_BLOCK_3P_5
SR_BELT_RL: CON_TERMINAL_BLOCK_03-5MM; TERMINAL_BLOCK_3P_5
SR_UD_L: CON_TERMINAL_BLOCK_03-5MM; TERMINAL_BLOCK_3P_5
SR_UD_R: CON_TERMINAL_BLOCK_03-5MM; TERMINAL_BLOCK_3P_5

Connections:
unnamed: ARDUINO_DIGITAL.1, BLUETOOTH.4
unnamed: ARDUINO_DIGITAL.2, BLUETOOTH.5
unnamed: ARDUINO_DIGITAL.3, SC1SENS1.3
unnamed: ARDUINO_DIGITAL.4, SC1SENS2.3
unnamed: ARDUINO_DIGITAL.5, SC2SENS.3
unnamed: ARDUINO_DIGITAL.11, SC3SENS.3
unnamed: ARDUINO_DIGITAL.7, RELAY1.2
unnamed: ARDUINO_DIGITAL.8, RELAY1.3
unnamed: ARDUINO_DIGITAL.9, RELAY1.4
unnamed: ARDUINO_DIGITAL.10, RELAY1.5
unnamed: ARDUINO_DIGITAL.12, RELAY2.2
unnamed: ARDUINO_DIGITAL.13, RELAY2.3
unnamed: ARDUINO_DIGITAL2.26, RELAY2.4
unnamed: ARDUINO_DIGITAL2.24, RELAY2.5
unnamed: ARDUINO_DIGITAL2.32, RELAY3.2
unnamed: ARDUINO_DIGITAL2.30, RELAY3.3
unnamed: ARDUINO_DIGITAL2.28, DSENS.3
unnamed: ARDUINO_DIGITAL2.22, RELAY3.4
unnamed: ARDUINO_DIGITAL2.20, RELAY3.5
unnamed: ARDUINO_DIGITAL2.34, RELAY4.2
unnamed: ARDUINO_DIGITAL2.33, RELAY4.3
unnamed: ARDUINO_DIGITAL2.14, RELAY4.4
unnamed: ARDUINO_DIGITAL2.31, RELAY4.5
unnamed: ARDUINO_POWER.6, BLUETOOTH.3, RELAY1.6, RELAY2.6, RELAY3.6, RELAY4.6
unnamed: ARDUINO_DIGITAL2.12, SRBSENS.3
unnamed: ARDUINO_DIGITAL2.27, SR_UD_R.1
unnamed: ARDUINO_DIGITAL2.25, SR_UD_R.2
unnamed: ARDUINO_DIGITAL2.23, SR_UD_R.3
unnamed: ARDUINO_DIGITAL2.21, SR_BELT_RL.2
unnamed: ARDUINO_DIGITAL2.19, SR_BELT_RL.1
unnamed: ARDUINO_DIGITAL2.17, SR_BELT_RL.3
unnamed: ARDUINO_DIGITAL2.15, HBS.1
unnamed: ARDUINO_DIGITAL2.13, HBS.2
unnamed: ARDUINO_DIGITAL2.11, HBS.3
unnamed: ARDUINO_DIGITAL2.9, HBSS.1
unnamed: ARDUINO_DIGITAL2.29, HBSS.2
unnamed: ARDUINO_DIGITAL2.8, SR_UD_L.2
unnamed: ARDUINO_DIGITAL2.18, SR_UD_L.3
unnamed: ARDUINO_DIGITAL2.16, SR_UD_L.1
unnamed: ARDUINO_DIGITAL2.35, ARDUINO_DIGITAL2.36, ARDUINO_POWER.4, DSENS.1, SC1SENS1.1, SC1SENS2.1, SC2SENS.1, SC3SENS.1, SRBSENS.1
unnamed: ARDUINO_DIGITAL.15, ARDUINO_DIGITAL2.1, ARDUINO_DIGITAL2.2, ARDUINO_POWER.5, BLUETOOTH.2, DSENS.2, RELAY1.1, RELAY2.1, RELAY3.1, RELAY4.1, SC1SENS1.2, SC1SENS2.2, SC2SENS.2, SC3SENS.2, SRBSENS.2

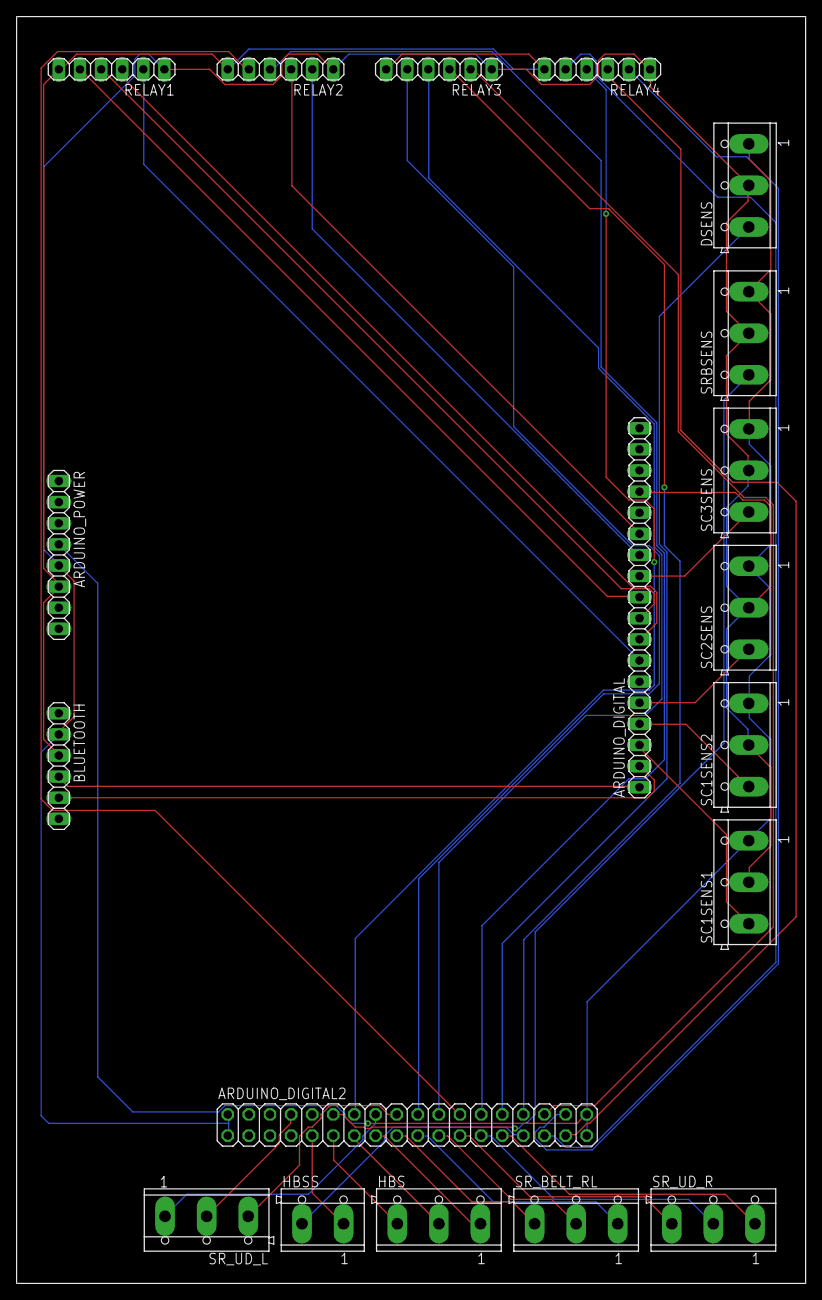
[picture p100: board hbs_pcb.brd from above]

Board: 2 copper layers, 94.9 x 152.4 mm, 19 parts (0 on the bottom side), 41 nets.
