skrishnachaitanya09/I-4.0-learning-Laboratory-/mfs/turntable/turntable/turntable.brd

## EAGLE design mfs/turntable/turntable/turntable.brd (2020-03-05)

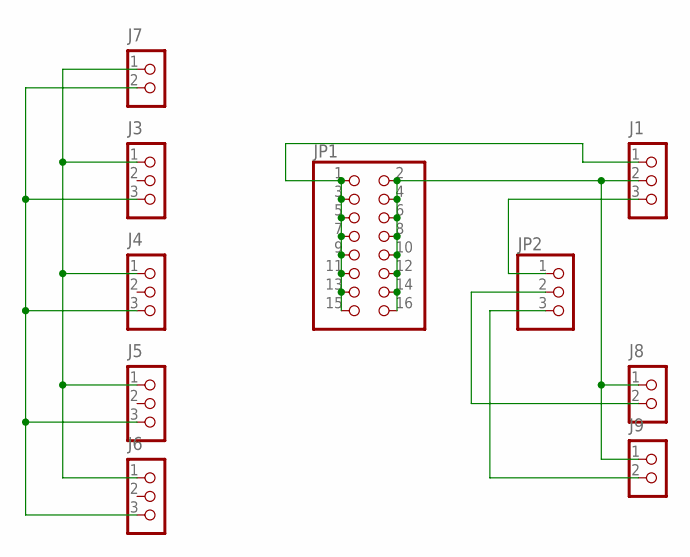
[picture p101: schematic turntable.sch]

Parts:
J1, J3, J4, J5, J6: CON_TERMINAL_BLOCK_03-5MM; TERMINAL_BLOCK_3P_5
J7, J8, J9: CON_TERMINAL_BLOCK_02-5MM; TERMINAL_BLOCK_2P_5
JP1: PINHD-2X8; 2X08
JP2: PINHD-1X3; 1X03

Connections:
unnamed: J1.1, JP1.1, JP1.3, JP1.5, JP1.7, JP1.9, JP1.11, JP1.13, JP1.15
unnamed: J1.2, J8.1, J9.1, JP1.2, JP1.4, JP1.6, JP1.8, JP1.10, JP1.12, JP1.14, JP1.16
unnamed: J1.3, JP2.1
unnamed: J8.2, JP2.2
unnamed: J3.1, J4.1, J5.1, J6.1, J7.1
unnamed: J9.2, JP2.3
unnamed: J3.3, J4.3, J5.3, J6.3, J7.2
