skrishnachaitanya09/I-4.0-learning-Laboratory-/mfs/turntable/turntable/turntable.brd

## EAGLE design mfs/turntable/turntable/turntable.brd (continued)

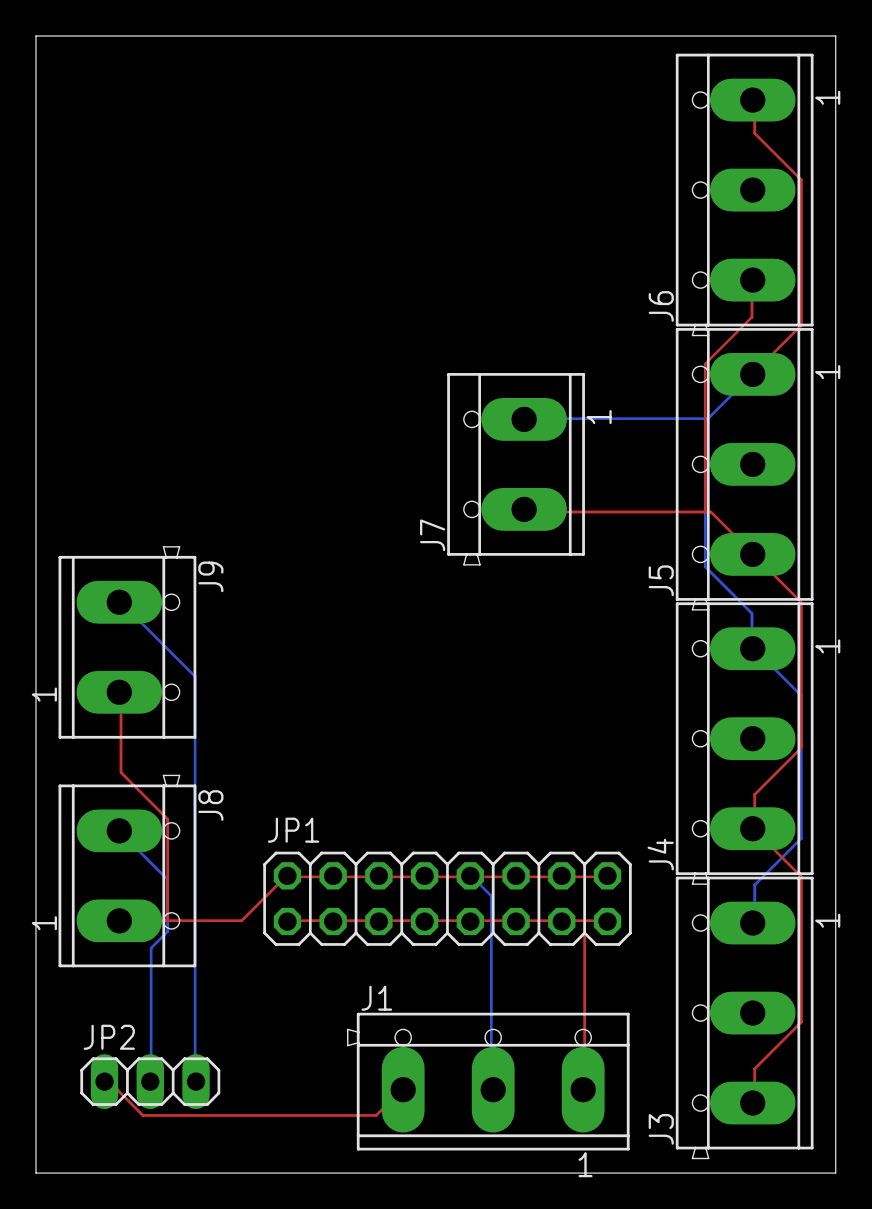
[picture p102: board turntable.brd from above]

Board: 2 copper layers, 44.4 x 63.2 mm, 10 parts (0 on the bottom side), 7 nets.
