skrishnachaitanya09/I-4.0-learning-Laboratory-/Circuit Schematics & Gerber Files/lifi/led/led.brd

## EAGLE design Circuit Schematics & Gerber Files/lifi/led/led.brd (2020-03-05)

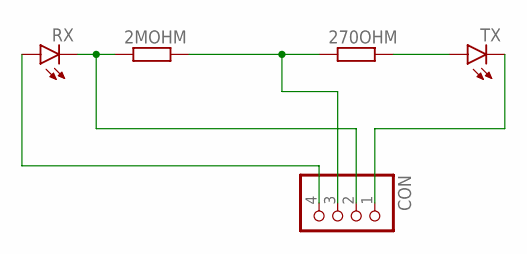
[picture p103: schematic led.sch]

Parts:
2MOHM, 270OHM: R-EU_0207/7; 0207/7
CON: PINHD-1X4; 1X04
RX: LED5MM
TX: LED5MM

Connections:
unnamed: 2MOHM.1, CON.2, RX.K (C)
unnamed: 2MOHM.2, 270OHM.1, CON.3
unnamed: 270OHM.2, TX.A
unnamed: CON.4, RX.A
unnamed: CON.1, TX.K (C)

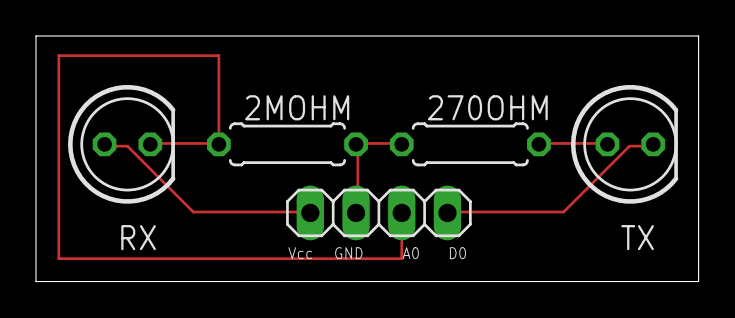
[picture p104: board led.brd from above]

Board: 2 copper layers, 36.8 x 13.6 mm, 5 parts (0 on the bottom side), 5 nets.
