skrishnachaitanya09/I-4.0-learning-Laboratory-/Circuit Schematics & Gerber Files/lifi/ldr/ldr.brd

## EAGLE design Circuit Schematics & Gerber Files/lifi/ldr/ldr.brd (2020-03-05)

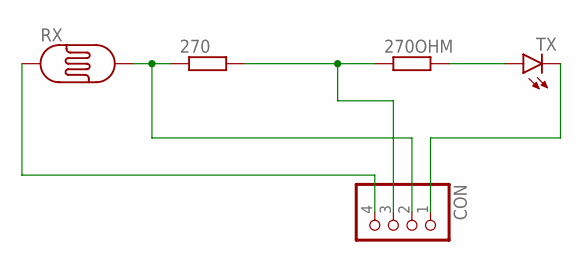
[picture p105: schematic ldr.sch]

Parts:
270, 270OHM: R-EU_0207/7; 0207/7
CON: PINHD-1X4; 1X04
RX: PHOTOCELLONB; ON_BOARD
TX: LED5MM

Connections:
unnamed: 270.1, CON.2, RX.2
unnamed: 270.2, 270OHM.1, CON.3
unnamed: 270OHM.2, TX.A
unnamed: CON.4, RX.1
unnamed: CON.1, TX.K (C)

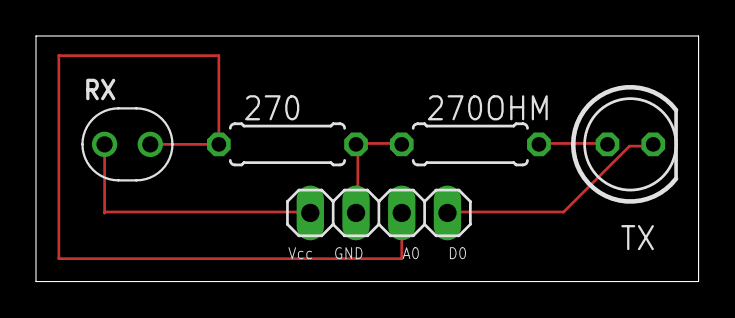
[picture p106: board ldr.brd from above]

Board: 2 copper layers, 36.8 x 13.6 mm, 5 parts (0 on the bottom side), 5 nets.
