skrishnachaitanya09/I-4.0-learning-Laboratory-/(commit log)

2020-03-05 Added Circuit schematics & Gerbers
    [conveyor.brd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]
2020-03-06 Added Robotic Arm test code
2020-03-09 conveyor test
2020-03-11 Device IDs added
    [deviceIDs.xlsx]
2020-03-21 source conveyor updated
2020-08-31 Added conveyor nRF basic code
2020-09-04 Added dispatch conveyor nRF code
2020-09-07 Added Arm Test code
2020-09-07 pcb designs
    [1.brd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]
2020-10-08 pcb files updated
    [1.brd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]
2020-10-27 Updated robotic arm code
2020-11-05 Added robotic arm nrf code in Test codes
2020-11-18 Replaced HBS Test code
    [HBS_Testing.ino, highbayshelf.h]
2020-11-26 highbay pcb added
    [1.brd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]
